Kageyana/robotrace_v1/README.md

# robotrace_v1

# 不具合情報
- リセット時にSDA端子がLOWに固定される.
  
  原因
  
  BNO055が通信中にリセットされBUSY状態になったから

参考

[STM32F1のI2Cの初期化でハマった](http://hima-tubusi.blogspot.com/2016/09/stm32f1i2c.html)

[STM32のI2C初期化で久しぶりにはまった](http://denshikousakusenka.blog.fc2.com/blog-entry-231.html)

[STM32のI2Cペリフェラルの初期化におけるヒント](https://www.stmcu.jp/design/document/technical_note/51180/)
