Kageyana/robotrace_v1/Circuit/robotrace_v1_main/robotrace_v1_main.step

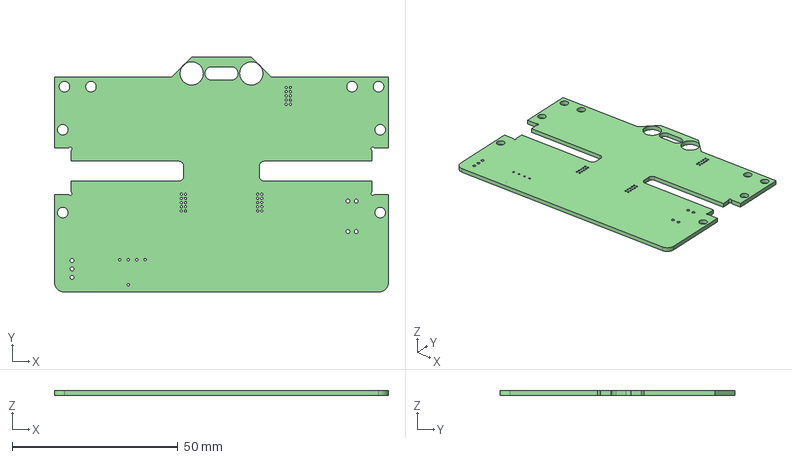
[picture p1: CAD file, 2023-08-02]
Circuit/robotrace_v1_main/robotrace_v1_main.step
100.8 x 71.0 x 1.60 mm
