Kageyana/robotrace_v1/Circuit/robotrace_v1_Linesensor/frontsensor2.dxf

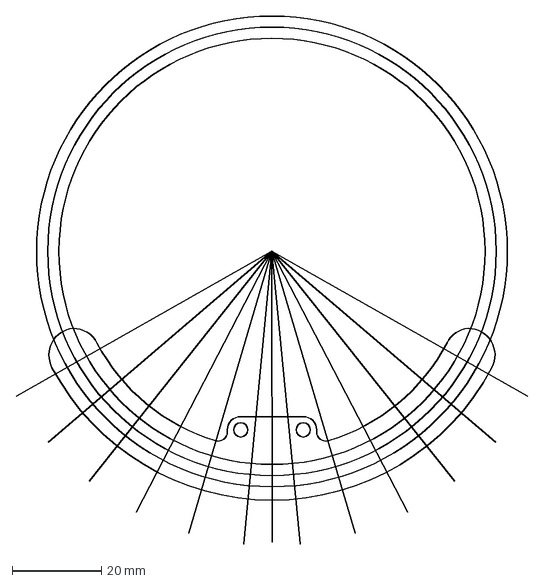
[picture p2: CAD file, 2023-08-02]
Circuit/robotrace_v1_Linesensor/frontsensor2.dxf
114.7 x 118.3 mm
