Kageyana/robotrace_v1/Circuit/robotrace_v1_main/plate.dxf

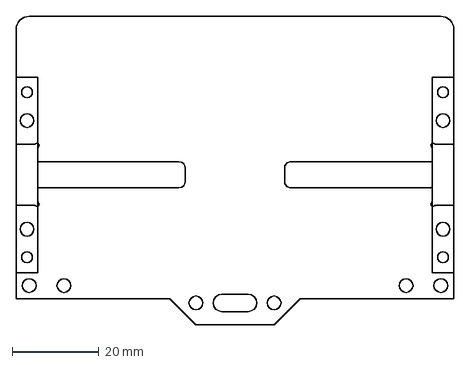
[picture p3: CAD file, 2023-08-02]
Circuit/robotrace_v1_main/plate.dxf
100.8 x 71.0 mm
