Kageyana/robotrace_v1/Circuit/robotrace_v1_Markersensor/Markersensor.dxf

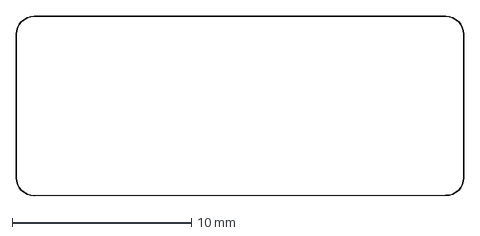
[picture p4: CAD file, 2023-08-02]
Circuit/robotrace_v1_Markersensor/Markersensor.dxf
25.0 x 10.0 mm
