Kageyana/robotrace_v1/Circuit/robotrace_v1_Linesensor/frontsensor.dxf

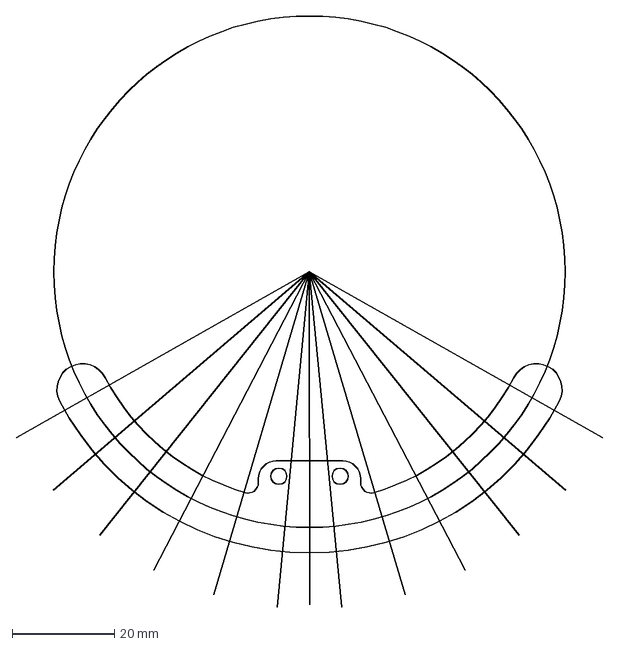
[picture p5: CAD file, 2023-08-02]
Circuit/robotrace_v1_Linesensor/frontsensor.dxf
114.7 x 115.6 mm
