Kageyana/robotrace_v1/Circuit/robotrace_v1_Linesensor/robotrace_v1_Linesensor.pdf

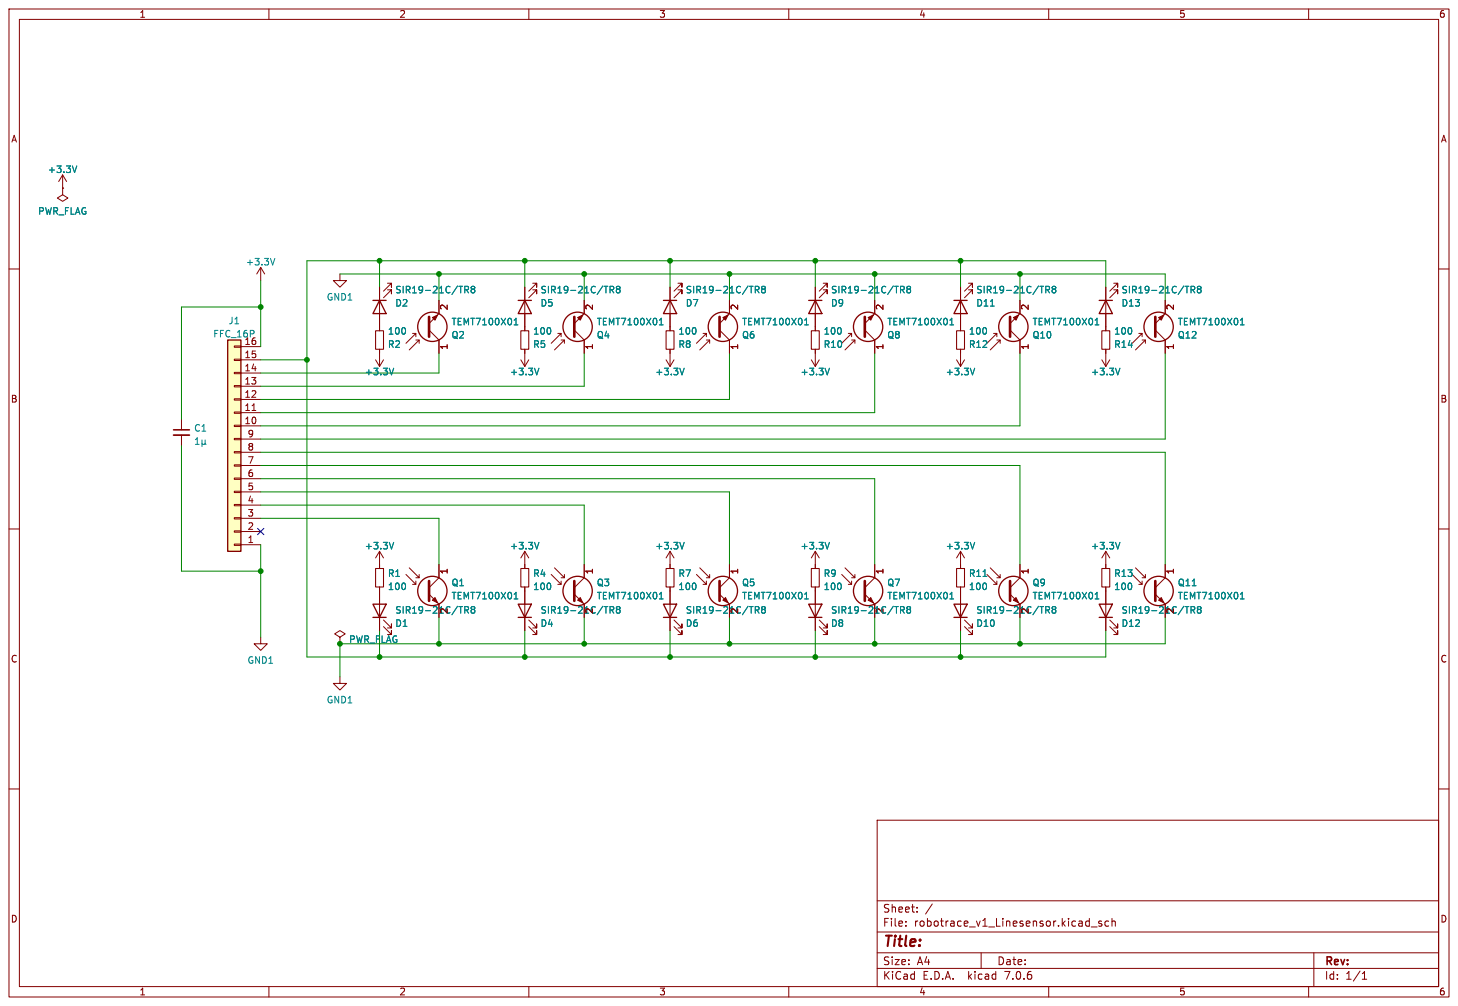
[picture p6: page 1]

Id: 1/1 Title: File: robotrace_v1_Linesensor.kicad_sch Sheet: /
