Kageyana/robotrace_v1/Circuit/robotrace_v1_Markersensor/robotrace_v1_Markersensor.pdf

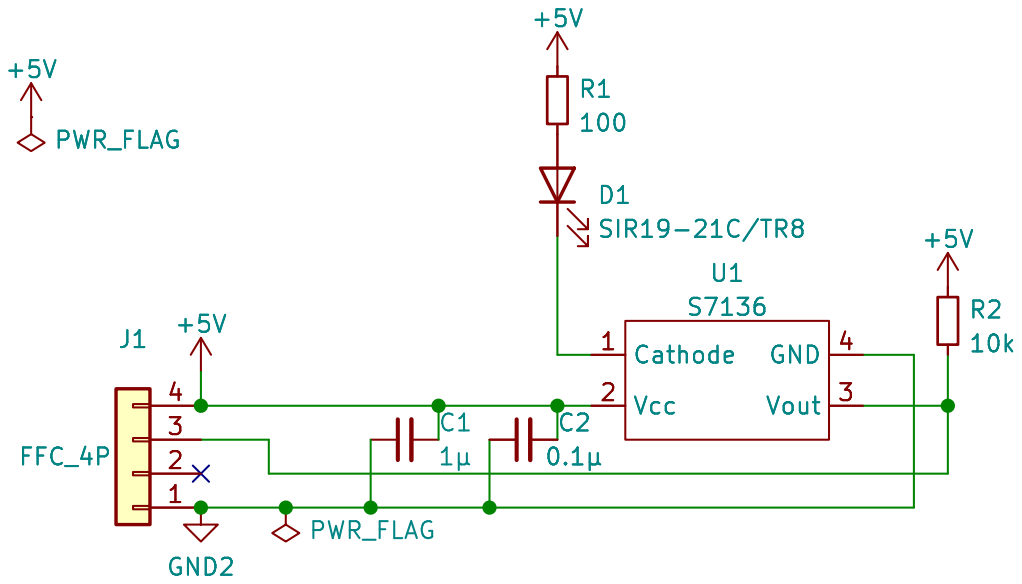
[picture p7: page 1]

Id: 1/1 Title: File: robotrace_v1_Markersensor.kicad_sch Sheet: /
