Kageyana/robotrace_v1/Circuit/robotrace_v1_main/main.pdf

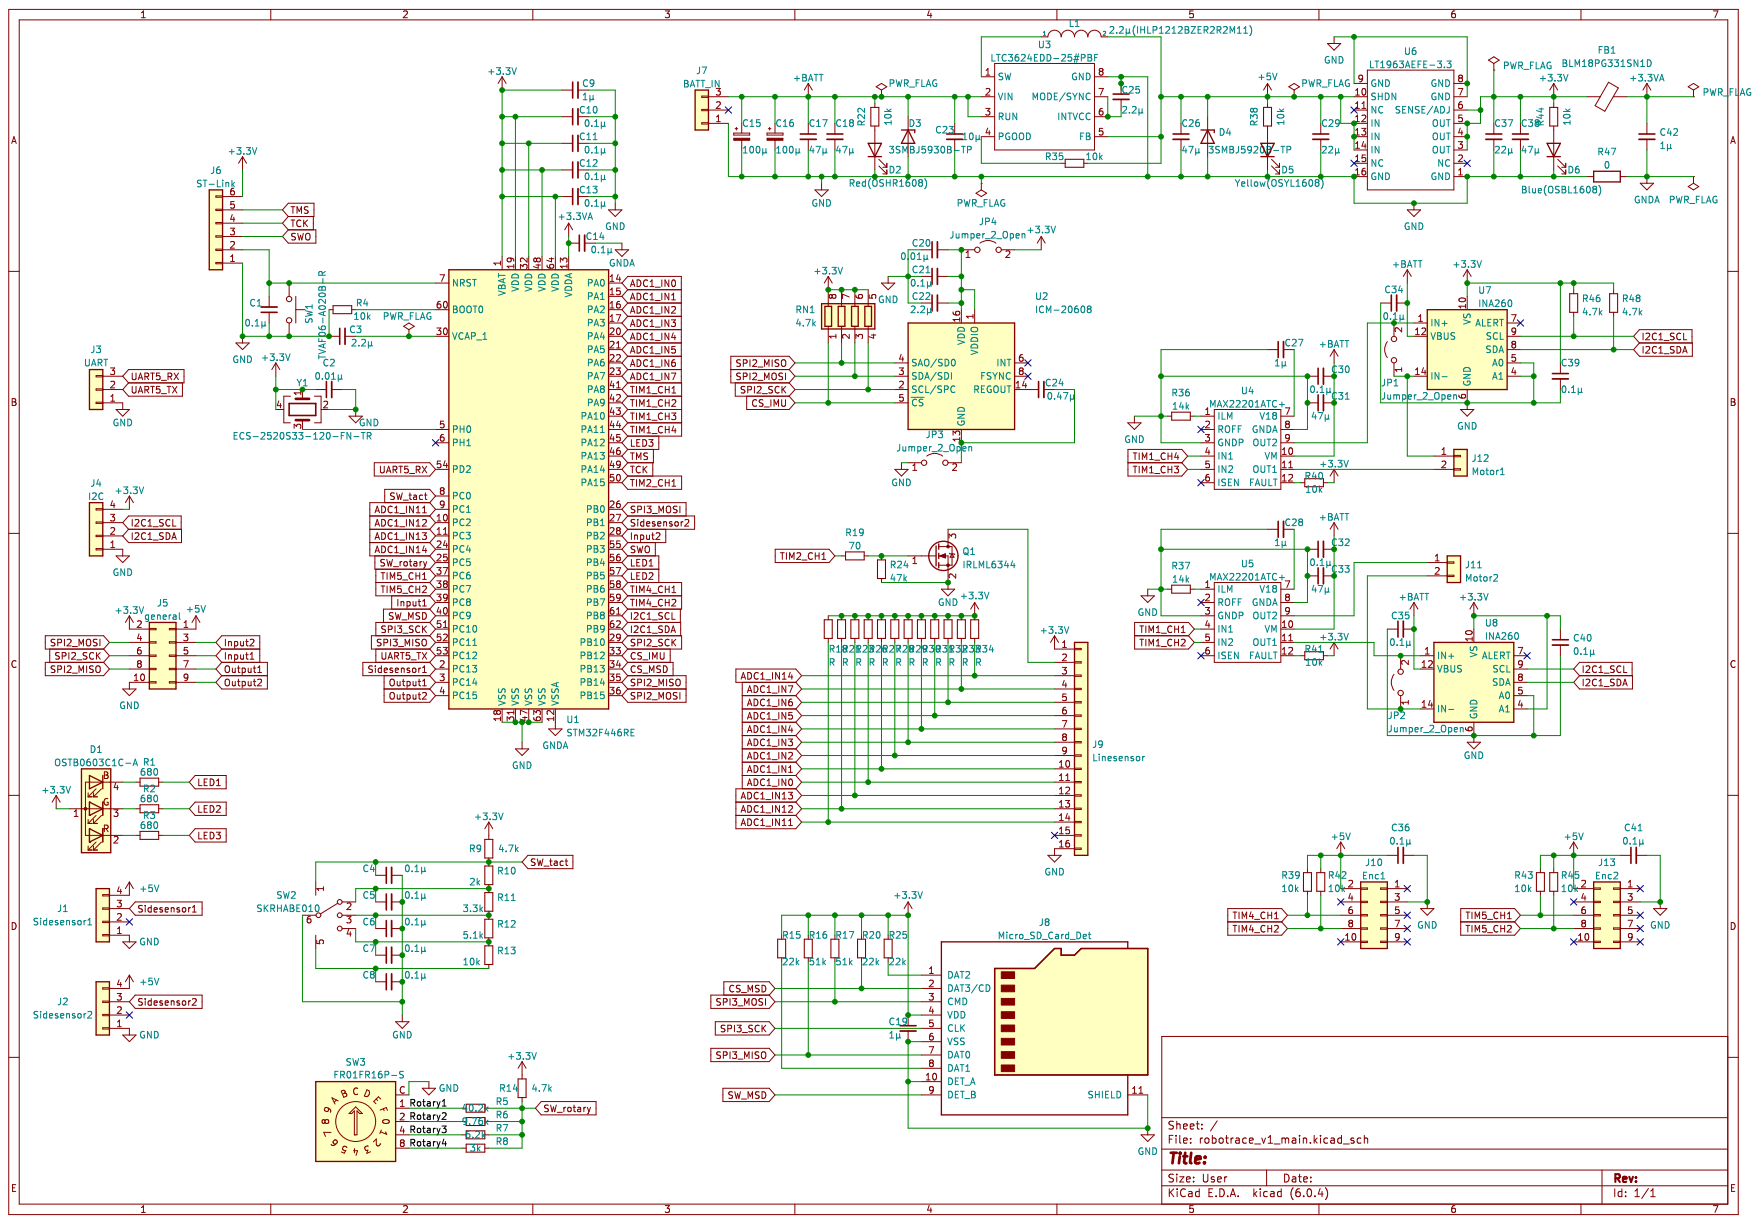
[picture p8: page 1]
