Kageyana/robotrace_v1/Circuit/robotrace_v1_main/robotrace_v1_main.kicad_pcb

## KiCad design Circuit/robotrace_v1_main/robotrace_v1_main.kicad_pcb (2023-08-02)

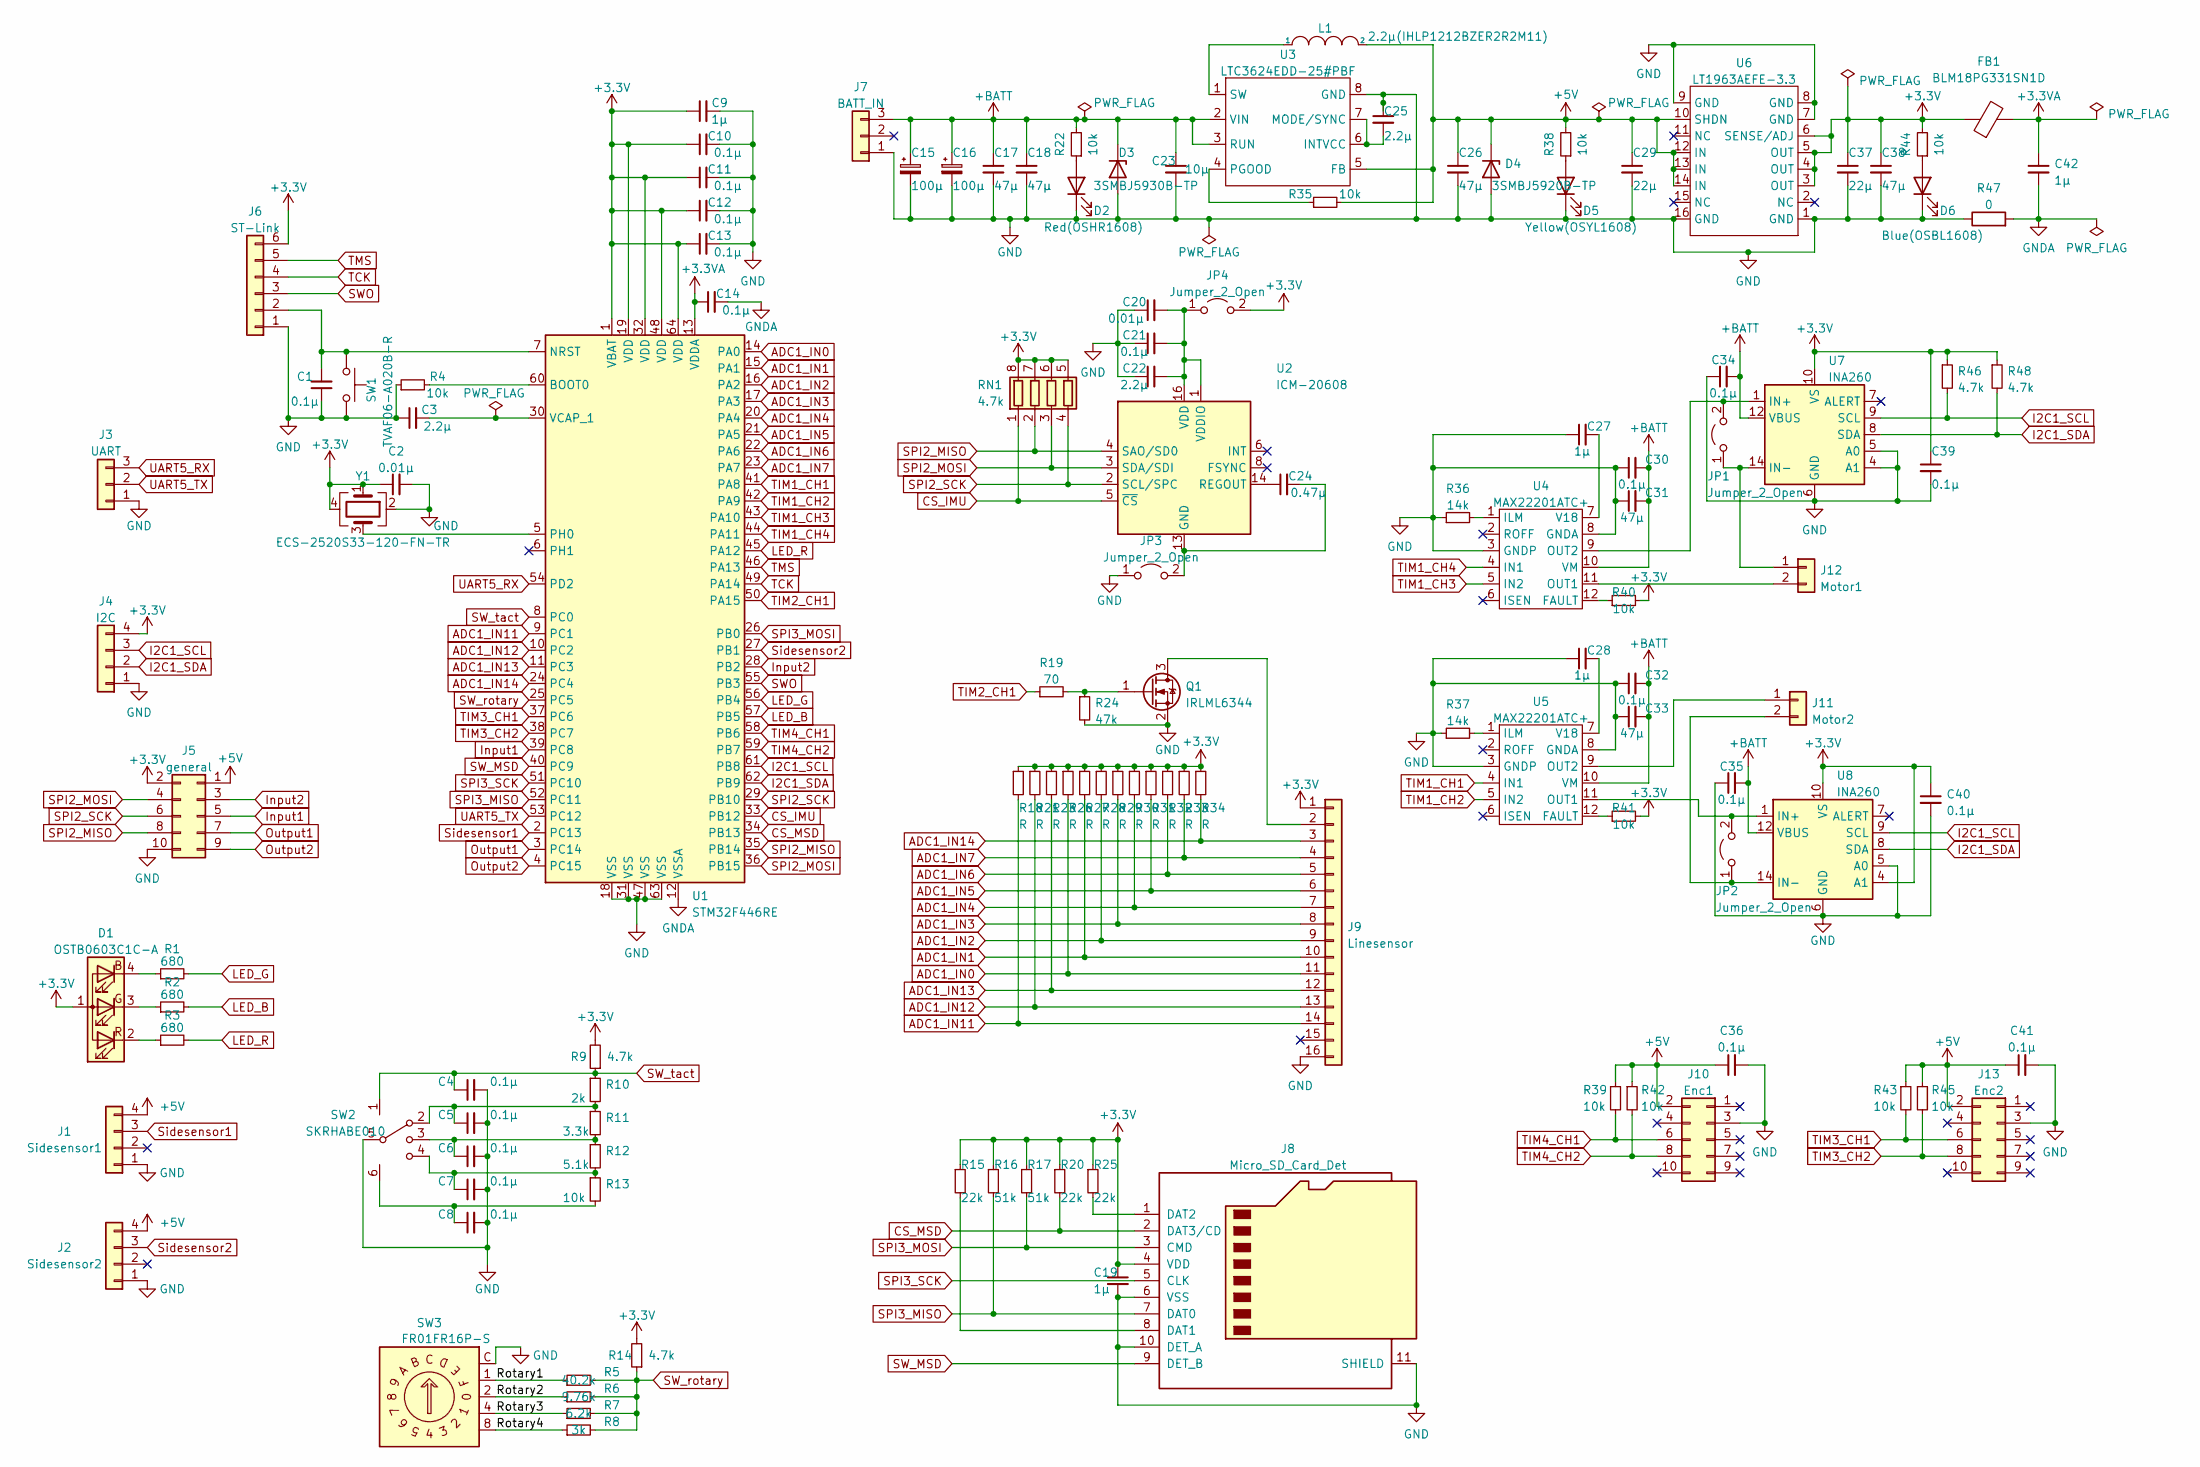
[picture p9: schematic robotrace_v1_main.kicad_sch]

Parts:
C1, C4, C5, C6, C7, C8, C10, C11, C12, C13, C14, C21, C30, C32, C34, C35, C36, C39, C40, C41: 0.1μ; C_0402_1005Metric_Pad0.74x0.62mm_HandSolder
C2, C20: 0.01μ; C_0402_1005Metric_Pad0.74x0.62mm_HandSolder
C3, C22, C25: 2.2μ; C_0402_1005Metric_Pad0.74x0.62mm_HandSolder
C9, C19, C27, C28, C42: 1μ; C_0402_1005Metric_Pad0.74x0.62mm_HandSolder
C15, C16: 100μ; CP_Elec_6.3x7.7
C17, C18, C26, C31, C33, C38: 47μ; C_1210_3225Metric_Pad1.33x2.70mm_HandSolder
C23: 10μ; C_0402_1005Metric_Pad0.74x0.62mm_HandSolder
C24: 0.47μ; C_0402_1005Metric_Pad0.74x0.62mm_HandSolder
C29: 22μ; C_0805_2012Metric_Pad1.18x1.45mm_HandSolder
C37: 22μ; C_0402_1005Metric_Pad0.74x0.62mm_HandSolder
D1: OSTB0603C1C-A; LED_Cree-PLCC4_2x2mm_CW
D2: Red(OSHR1608); LED_0603_1608Metric_Pad1.05x0.95mm_HandSolder
D3: 3SMBJ5930B-TP; D_SMA
D4: 3SMBJ5920B-TP; D_SMA
D5: Yellow(OSYL1608); LED_0603_1608Metric_Pad1.05x0.95mm_HandSolder
D6: Blue(OSBL1608); LED_0603_1608Metric_Pad1.05x0.95mm_HandSolder
FB1: BLM18PG331SN1D; D_0603_1608Metric
J1: Sidesensor1; Molex_FFC_1x4-1MP_P0.5mm_Horizontal
J2: Sidesensor2; Molex_FFC_1x4-1MP_P0.5mm_Horizontal
J3: UART; JST_SH_BM03B-SRSS-TB_1x03-1MP_P1.00mm_Vertical
J4: I2C; JST_SH_BM04B-SRSS-TB_1x04-1MP_P1.00mm_Vertical
J5: general; PinSocket_2x05_P1.27mm_Vertical
J6: ST-Link; JST_SH_BM06B-SRSS-TB_1x06-1MP_P1.00mm_Vertical
J7: BATT_IN; Molex_mini-SPOX_1x03_P2.54mm_Vertical
J8: Micro_SD_Card_Det; microSD_HC_Hirose_DM3AT-SF-PEJM5
J9: Linesensor; Molex_1x16_P0.50mm_Horizontal
J10: Enc1; PinSocket_2x05_P1.27mm_Vertical
J11: Motor2; Molex_mini-SPOX_1x02_P2.54mm_Vertical
J12: Motor1; Molex_mini-SPOX_1x02_P2.54mm_Vertical
J13: Enc2; PinSocket_2x05_P1.27mm_Vertical
JP1, JP2, JP3, JP4: Jumper_2_Open; SolderJumper-2_P1.3mm_Open_TrianglePad1.0x1.5mm
L1: 2.2μ(IHLP1212BZER2R2M11); L_Vishay_IHLP-1212
Q1: IRLML6344; SOT-23
R1, R2, R3: 680; R_0603_1608Metric
R4, R13, R22, R35, R38, R39, R40, R41, R42, R43, R44, R45: 10k; R_0603_1608Metric
R5: 40.2k; R_0603_1608Metric
R6: 9.76k; R_0603_1608Metric
R7: 6.2k; R_0603_1608Metric
R8: 3k; R_0603_1608Metric
R9, R14, R46, R48: 4.7k; R_0603_1608Metric
R10: 2k; R_0603_1608Metric
R11: 3.3k; R_0603_1608Metric
R12: 5.1k; R_0603_1608Metric
R15, R20, R25: 22k; R_0603_1608Metric
R16, R17: 51k; R_0603_1608Metric
R18, R21, R23, R26, R27, R28, R29, R30, R31, R32, R33, R34: R; R_0603_1608Metric
R19: 70; R_0603_1608Metric
R24: 47k; R_0603_1608Metric
R36, R37: 14k; R_0603_1608Metric
R47: 0; R_0603_1608Metric
RN1: 4.7k; R_Array_Convex_4x0402
SW1: TVAF06-A020B-R; SW_Push_SPST_NO_Alps_SKRK
SW2: SKRHABE010; SKRHAAE010
SW3: FR01FR16P-S
U1: STM32F446RE; LQFP-64_10x10mm_P0.5mm
U2: ICM-20608; LGA-16_3x3mm_P0.5mm_LayoutBorder3x5y
U3: LTC3624EDD-25#PBF; DFN-8-1EP_3x3mm_P0.5mm_EP1.65x2.38mm
U4, U5: MAX22201ATC+; DFN-12-1EP_3x3mm_P0.5mm_EP1.6x2.5mm
U6: LT1963AEFE-3.3; HTSSOP-16-1EP_4.4x5mm_P0.65mm_EP3.4x5mm
U7, U8: INA260; TSSOP-16_4.4x5mm_P0.65mm
Y1: ECS-2520S33-120-FN-TR; Crystal_SMD_EuroQuartz_MT-4Pin_3.2x2.5mm

Connections:
+3.3VA: C14.1, C42.1, FB1.2, U1.13 (VDDA)
+3V3: C2.1, C9.1, C10.1, C11.1, C12.1, C13.1, C19.1, C37.1, C38.1, C39.1, C40.1, D1.1 (A), FB1.1, J4.4, J5.2, J6.6, J8.4 (VDD), J9.1, JP4.2 (B), R9.2, R14.2, R15.1, R16.1, R17.1, R18.1, R20.1, R21.1, R23.1, R25.1, R26.1, R27.1, R28.1, R29.1, R30.1, R31.1, R32.1, R33.1, R34.1, R40.2, R41.2, R44.2, R46.1, R48.1, RN1.5 (R4.2), RN1.6 (R3.2), RN1.7 (R2.2), RN1.8 (R1.2), U1.1 (VBAT), U1.19 (VDD), U1.32 (VDD), U1.48 (VDD), U1.64 (VDD), U6.3 (OUT), U6.4 (OUT), U6.5 (OUT), U6.6 (SENSE/ADJ), U7.10 (VS), U8.4 (A1), U8.10 (VS), Y1.1, Y1.4
+5V: C26.1, C29.1, C36.1, C41.1, D4.1 (K), J1.4, J2.4, J5.1, J10.2, J13.2, L1.2, R35.2, R38.2, R39.1, R42.1, R43.1, R45.1, U3.5 (FB), U6.10 (SHDN), U6.12 (IN), U6.13 (IN), U6.14 (IN)
+BATT: C15.1, C16.1, C17.1, C18.1, C23.1, C30.2, C31.2, C32.2, C33.2, C34.2, C35.2, D3.1 (K), J7.3, R22.2, U3.2 (VIN), U3.3 (RUN), U4.10 (VM), U5.10 (VM), U7.12 (VBUS), U8.12 (VBUS)
/Rotary1: R5.1, SW3.1
/Rotary2: R6.1, SW3.2
/Rotary3: R7.1, SW3.4
/Rotary4: R8.1, SW3.8
ADC1_IN0: J9.11, R26.2, U1.14 (PA0)
ADC1_IN1: J9.10, R27.2, U1.15 (PA1)
ADC1_IN2: J9.9, R28.2, U1.16 (PA2)
ADC1_IN3: J9.8, R29.2, U1.17 (PA3)
ADC1_IN4: J9.7, R30.2, U1.20 (PA4)
ADC1_IN5: J9.6, R31.2, U1.21 (PA5)
ADC1_IN6: J9.5, R32.2, U1.22 (PA6)
ADC1_IN7: J9.4, R33.2, U1.23 (PA7)
ADC1_IN11: J9.14, R18.2, U1.9 (PC1)
ADC1_IN12: J9.13, R21.2, U1.10 (PC2)
ADC1_IN13: J9.12, R23.2, U1.11 (PC3)
ADC1_IN14: J9.3, R34.2, U1.24 (PC4)
CS_IMU: RN1.1 (R1.1), U1.33 (PB12), U2.5 (~CS)
CS_MSD: J8.2 (DAT3/CD), R20.2, U1.34 (PB13)
GNDA: C14.2, C42.2, R47.2, U1.12 (VSSA)
I2C1_SCL: J4.3, R46.2, U1.61 (PB8), U7.9 (SCL), U8.9 (SCL)
I2C1_SDA: J4.2, R48.2, U1.62 (PB9), U7.8 (SDA), U8.8 (SDA)
Input1: J5.5, U1.39 (PC8)
Input2: J5.3, U1.28 (PB2)
LED1: R1.2, U1.56 (PB4)
LED2: R2.2, U1.57 (PB5)
LED3: R3.2, U1.45 (PA12)
unnamed: C1.2, J6.2, SW1.1, U1.7 (NRST)
unnamed: C3.2, U1.30 (VCAP_1)
unnamed: C5.1, R10.2, R11.1, SW2.2
unnamed: C6.1, R11.2, R12.1, SW2.3
unnamed: C7.1, R12.2, R13.1, SW2.4
unnamed: C20.2, C21.2, C22.2, JP4.1 (A), U2.1 (VDDIO), U2.16 (VDD)
unnamed: C24.1, U2.14 (REGOUT)
unnamed: C24.2, JP3.2 (B), U2.9 (GND), U2.10 (GND), U2.11 (GND), U2.12 (GND), U2.13 (GND), U2.15 (GND)
unnamed: C25.2, U3.6 (INTVCC), U3.7 (MODE/SYNC)
unnamed: C27.2, U4.7 (V18)
unnamed: C28.2, U5.7 (V18)
unnamed: D1.2 (RK), R3.1
unnamed: D1.3 (GK), R2.1
unnamed: D1.4 (BK), R1.1
unnamed: D2.2 (A), R22.1
unnamed: D5.2 (A), R38.1
unnamed: D6.2 (A), R44.1
unnamed: J8.1 (DAT2), R25.2
unnamed: J8.8 (DAT1), R15.2
unnamed: J9.2, Q1.3 (D)
unnamed: J11.1, U5.9 (OUT2)
unnamed: J11.2, JP2.1 (A), U8.14 (IN-), U8.15 (IN-), U8.16 (IN-)
unnamed: J12.1, JP1.1 (A), U7.14 (IN-), U7.15 (IN-), U7.16 (IN-)
unnamed: J12.2, U4.11 (OUT1)
unnamed: JP1.2 (B), U4.9 (OUT2), U7.1 (IN+), U7.2 (IN+), U7.3 (IN+)
unnamed: JP2.2 (B), U5.11 (OUT1), U8.1 (IN+), U8.2 (IN+), U8.3 (IN+)
unnamed: L1.1, U3.1 (SW)
unnamed: Q1.1 (G), R19.2, R24.1
unnamed: R4.2, U1.60 (BOOT0)
unnamed: R35.1, U3.4 (PGOOD)
unnamed: R36.2, U4.1 (ILM)
unnamed: R37.2, U5.1 (ILM)
unnamed: R40.1, U4.12 (FAULT)
unnamed: R41.1, U5.12 (FAULT)
unnamed: U1.5 (PH0), Y1.3
Output1: J5.7, U1.3 (PC14)
Output2: J5.9, U1.4 (PC15)
SPI2_MISO: J5.8, RN1.2 (R2.1), U1.35 (PB14), U2.4 (SAO/SD0)
SPI2_MOSI: J5.4, RN1.3 (R3.1), U1.36 (PB15), U2.3 (SDA/SDI)
SPI2_SCK: J5.6, RN1.4 (R4.1), U1.29 (PB10), U2.2 (SCL/SPC)
SPI3_MISO: J8.7 (DAT0), R16.2, U1.52 (PC11)
SPI3_MOSI: J8.3 (CMD), R17.2, U1.26 (PB0)
SPI3_SCK: J8.5 (CLK), U1.51 (PC10)
SWO: J6.3, U1.55 (PB3)
SW_MSD: J8.9 (DET_B), U1.40 (PC9)
SW_rotary: R5.2, R6.2, R7.2, R8.2, R14.1, U1.25 (PC5)
SW_tact: C4.1, R9.1, R10.1, SW2.1, U1.8 (PC0)
Sidesensor1: J1.3, U1.2 (PC13)
Sidesensor2: J2.3, U1.27 (PB1)
TCK: J6.4, U1.49 (PA14)
TIM1_CH1: U1.41 (PA8), U5.4 (IN1)
TIM1_CH2: U1.42 (PA9), U5.5 (IN2)
TIM1_CH3: U1.43 (PA10), U4.5 (IN2)
TIM1_CH4: U1.44 (PA11), U4.4 (IN1)
TIM2_CH1: R19.1, U1.50 (PA15)
TIM4_CH1: J10.6, R39.2, U1.58 (PB6)
TIM4_CH2: J10.8, R42.2, U1.59 (PB7)
TIM5_CH1: J13.6, R43.2, U1.37 (PC6)
TIM5_CH2: J13.8, R45.2, U1.38 (PC7)
TMS: J6.5, U1.46 (PA13)
UART5_RX: J3.3, U1.54 (PD2)
UART5_TX: J3.2, U1.53 (PC12)

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
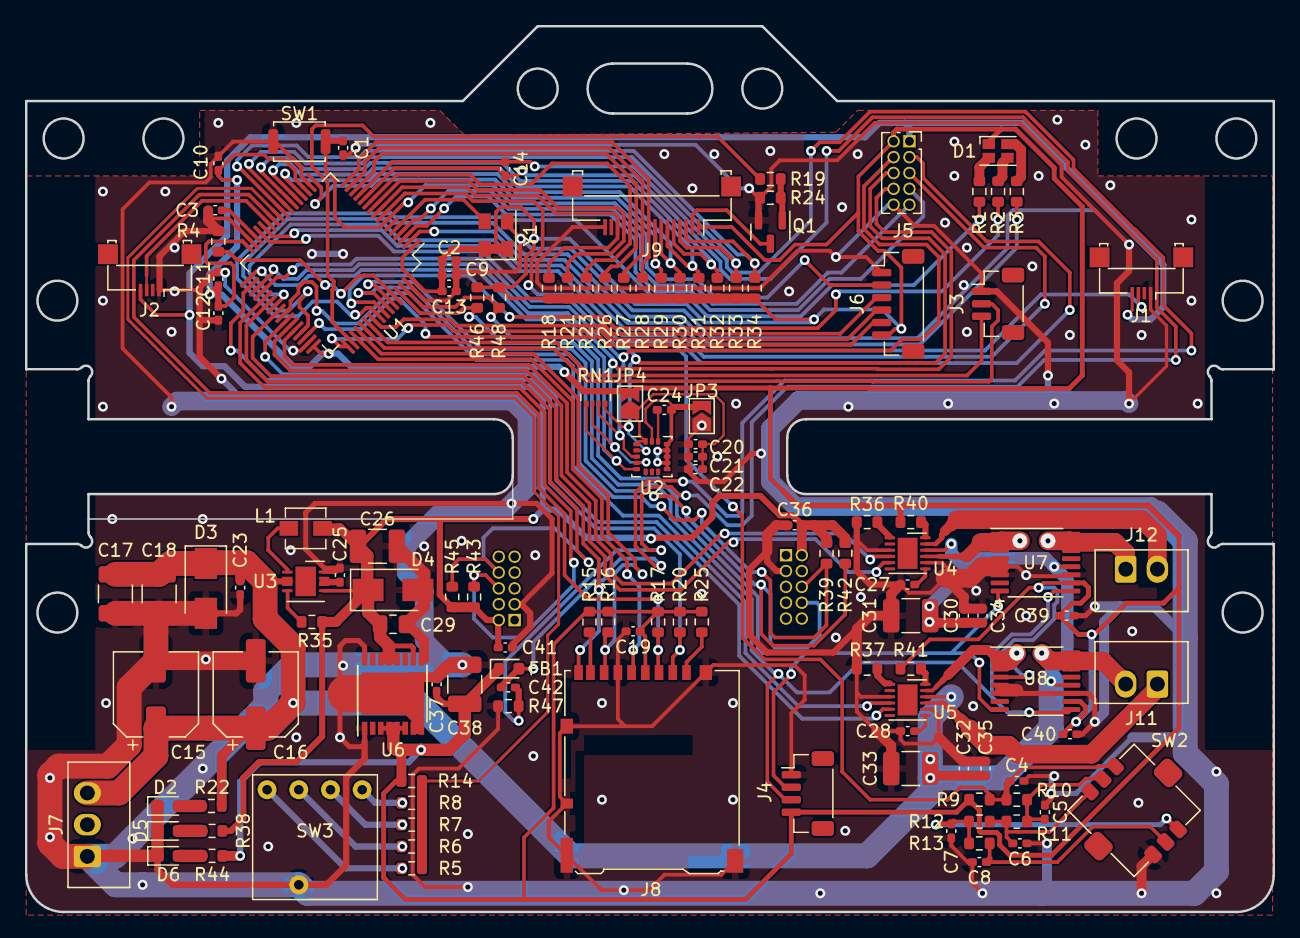
[picture p10: board robotrace_v1_main.kicad_pcb from above]

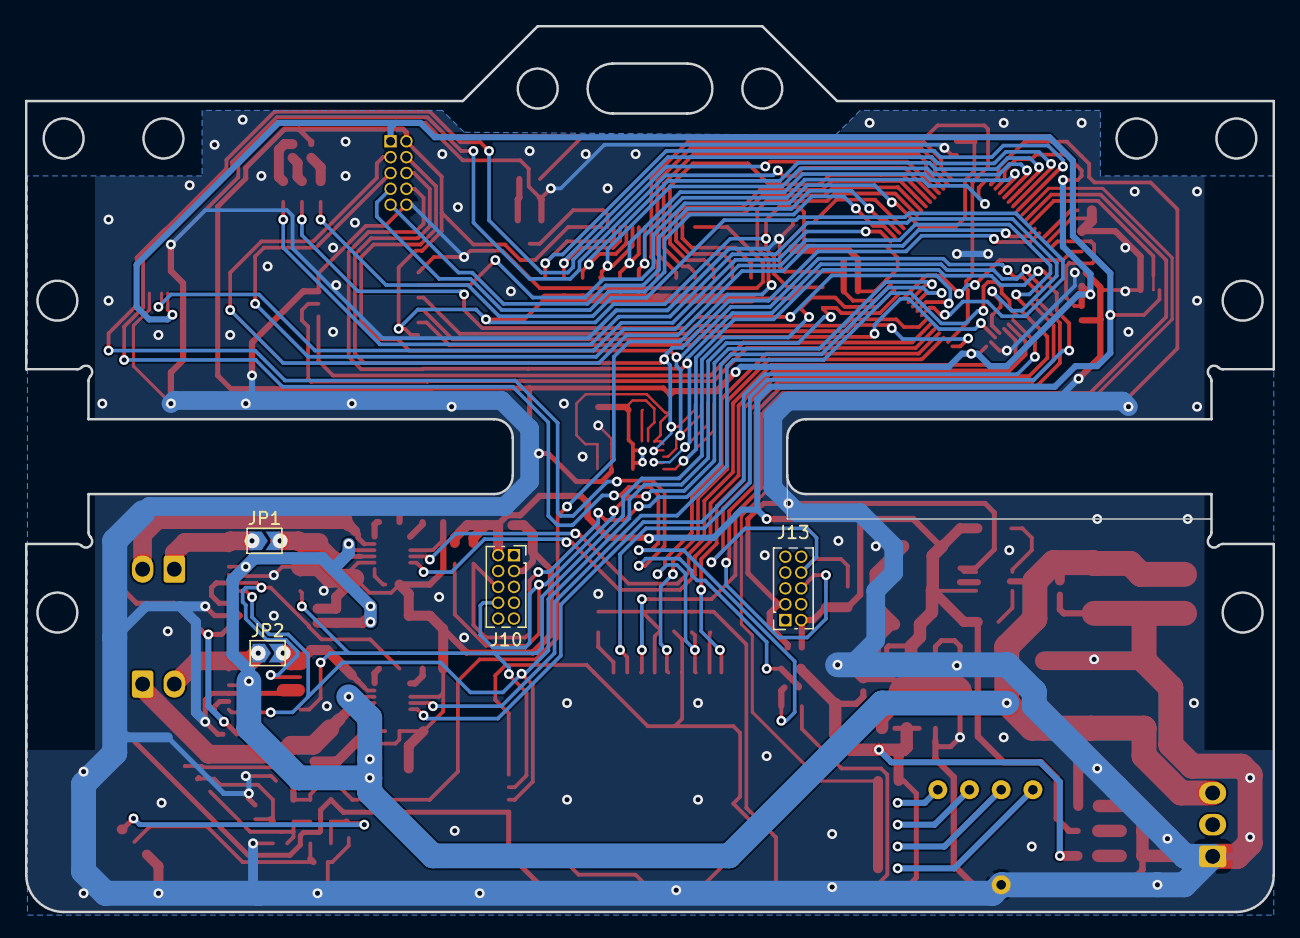
[picture p11: board robotrace_v1_main.kicad_pcb from below]

Board: 2 copper layers, 100.0 x 71.0 mm, 129 parts (4 on the bottom side), 94 nets.
