Kageyana/robotrace_v1/Circuit/robotrace_v1_Markersensor/robotrace_v1_Markersensor.kicad_pcb

## KiCad design Circuit/robotrace_v1_Markersensor/robotrace_v1_Markersensor.kicad_pcb (2023-08-02)

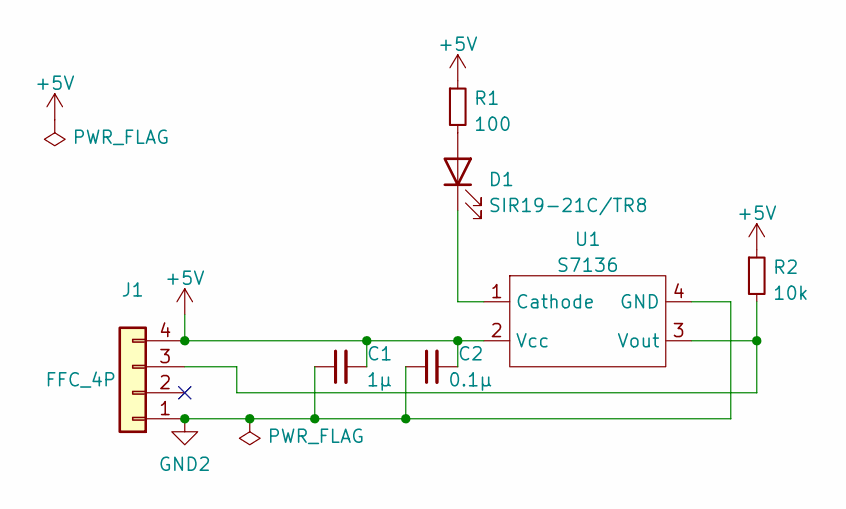
[picture p14: schematic robotrace_v1_Markersensor.kicad_sch]

Parts:
C1: 1μ; C_0402_1005Metric_Pad0.74x0.62mm_HandSolder
C2: 0.1μ; C_0402_1005Metric_Pad0.74x0.62mm_HandSolder
D1: SIR19-21C/TR8; LED_0603_1608Metric_Pad1.05x0.95mm_HandSolder
J1: FFC_4P; Molex_FFC_1x4-1MP_P0.5mm_Horizontal
R1: 100; R_0603_1608Metric_Pad0.98x0.95mm_HandSolder
R2: 10k; R_0603_1608Metric_Pad0.98x0.95mm_HandSolder
U1: S7136

Connections:
+5V: C1.2, C2.2, J1.4, R1.1, R2.1, U1.2 (Vcc)
GND2: C1.1, C2.1, J1.1, U1.4 (GND)
unnamed: D1.1 (K), U1.1 (Cathode)
unnamed: D1.2 (A), R1.2
unnamed: J1.3, R2.2, U1.3 (Vout)

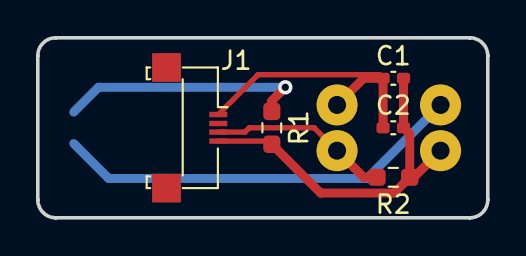
[picture p15: board robotrace_v1_Markersensor.kicad_pcb from above]

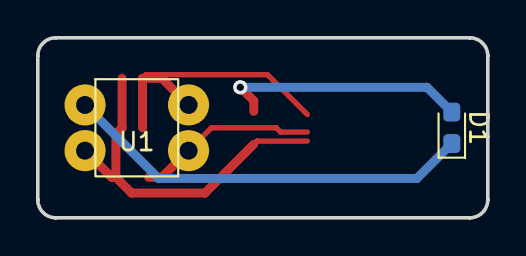
[picture p16: board robotrace_v1_Markersensor.kicad_pcb from below]

Board: 2 copper layers, 25.0 x 10.0 mm, 7 parts (2 on the bottom side), 5 nets.
