Kageyana/robotrace_v1/Circuit/robotrace_v1_Linesensor/total.kicad_pcb

## KiCad design Circuit/robotrace_v1_Linesensor/total.kicad_pcb (2023-08-02)

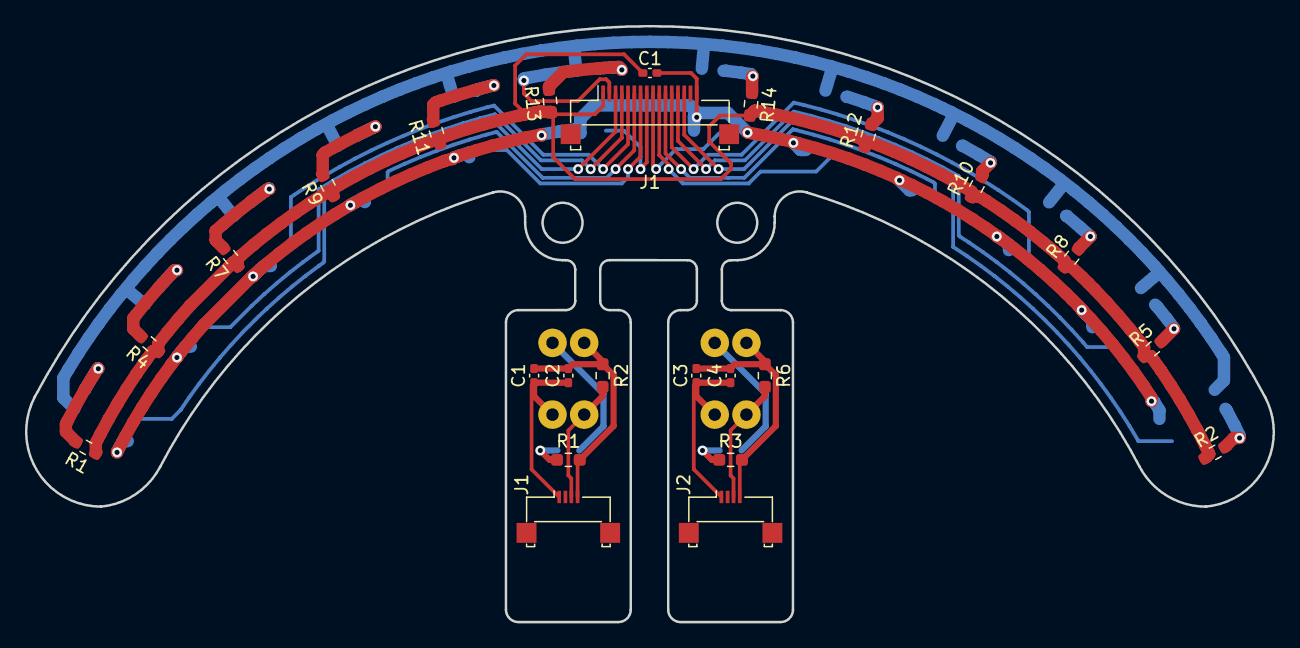
[picture p17: board total.kicad_pcb from above]

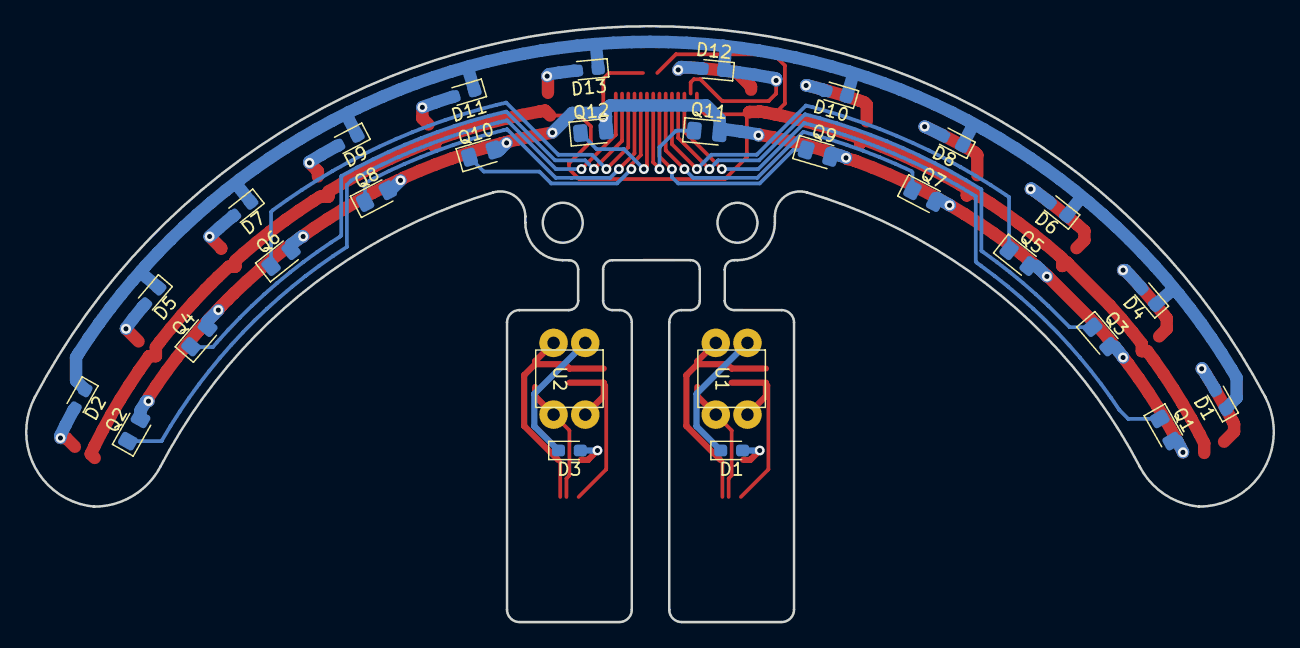
[picture p18: board total.kicad_pcb from below]

Board: 2 copper layers, 100.0 x 47.7 mm, 52 parts (28 on the bottom side), 29 nets.

Parts:
C1, C1#2, C3: 1μ; C_0402_1005Metric_Pad0.74x0.62mm_HandSolder
C2, C4: 0.1μ; C_0402_1005Metric_Pad0.74x0.62mm_HandSolder
D1, D1#2, D2, D3, D4, D5, D6, D7, D8, D9, D10, D11, D12, D13: SIR19-21C/TR8; LED_0603_1608Metric_Pad1.05x0.95mm_HandSolder
J1, J2: FFC_4P; Molex_FFC_1x4-1MP_P0.5mm_Horizontal
J1#2: FFC_16P; Molex_1x16_P0.50mm_Horizontal
Q1, Q2, Q3, Q4, Q5, Q6, Q7, Q8, Q9, Q10, Q11, Q12: TEMT7100X01; LED_0805_2012Metric_Pad1.15x1.40mm_HandSolder
R1, R1#2, R2#2, R3, R4, R5, R7, R8, R9, R10, R11, R12, R13, R14: 100; R_0603_1608Metric_Pad0.98x0.95mm_HandSolder
R2, R6: 10k; R_0603_1608Metric_Pad0.98x0.95mm_HandSolder
U1, U2: S7136

Connections:
+3V3: C1#2.1, J1#2.1, R1#2.1, R2#2.1, R4.1, R5.1, R7.1, R8.1, R9.1, R10.1, R11.1, R12.1, R13.1, R14.1
+5V: C1.2, C2.2, C3.2, C4.2, J1.4, J2.4, R1.1, R2.1, R3.1, R6.1, U1.2 (Vcc), U2.2 (Vcc)
GND1: C1#2.2, J1#2.16, Q1.2 (E), Q2.2 (E), Q3.2 (E), Q4.2 (E), Q5.2 (E), Q6.2 (E), Q7.2 (E), Q8.2 (E), Q9.2 (E), Q10.2 (E), Q11.2 (E), Q12.2 (E)
GND2: C1.1, C2.1, C3.1, C4.1, J1.1, J2.1, U1.4 (GND), U2.4 (GND)
unnamed: D1.1 (K), D1#2.1 (K), D2.1 (K), D3.1 (K), D4.1 (K), D5.1 (K), D6.1 (K), D7.1 (K), D8.1 (K), D9.1 (K), D10.1 (K), D11.1 (K), D12.1 (K), D13.1 (K), J1#2.2, U1.1 (Cathode), U2.1 (Cathode)
unnamed: D1.2 (A), D1#2.2 (A), D3.2 (A), R1.2, R1#2.2, R3.2
unnamed: D2.2 (A), R2#2.2
unnamed: D4.2 (A), R4.2
unnamed: D5.2 (A), R5.2
unnamed: D6.2 (A), R7.2
unnamed: D7.2 (A), R8.2
unnamed: D8.2 (A), R9.2
unnamed: D9.2 (A), R10.2
unnamed: D10.2 (A), R11.2
unnamed: D11.2 (A), R12.2
unnamed: D12.2 (A), R13.2
unnamed: D13.2 (A), R14.2
unnamed: J1.3, J1#2.3, J2.3, Q1.1 (C), R2.2, R6.2, U1.3 (Vout), U2.3 (Vout)
unnamed: J1#2.4, Q3.1 (C)
unnamed: J1#2.5, Q5.1 (C)
unnamed: J1#2.6, Q7.1 (C)
unnamed: J1#2.7, Q9.1 (C)
unnamed: J1#2.8, Q11.1 (C)
unnamed: J1#2.9, Q12.1 (C)
unnamed: J1#2.10, Q10.1 (C)
unnamed: J1#2.11, Q8.1 (C)
unnamed: J1#2.12, Q6.1 (C)
unnamed: J1#2.13, Q4.1 (C)
unnamed: J1#2.14, Q2.1 (C)
