Kageyana/robotrace_v1/robotrace_v1/Core/Src/main.c

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
/* Includes ------------------------------------------------------------------*/
#include "main.h"
#include "fatfs.h"

ADC_HandleTypeDef hadc1;
ADC_HandleTypeDef hadc2;
DMA_HandleTypeDef hdma_adc1;

I2C_HandleTypeDef hi2c1;

SPI_HandleTypeDef hspi2;
SPI_HandleTypeDef hspi3;

TIM_HandleTypeDef htim1;
TIM_HandleTypeDef htim2;
TIM_HandleTypeDef htim3;
TIM_HandleTypeDef htim4;
TIM_HandleTypeDef htim6;
TIM_HandleTypeDef htim7;

UART_HandleTypeDef huart5;

void SystemClock_Config(void);
static void MX_GPIO_Init(void);
static void MX_DMA_Init(void);
static void MX_ADC1_Init(void);
static void MX_I2C1_Init(void);
static void MX_SPI2_Init(void);
static void MX_TIM1_Init(void);
static void MX_TIM2_Init(void);
static void MX_UART5_Init(void);
static void MX_TIM3_Init(void);
static void MX_TIM4_Init(void);
static void MX_SPI3_Init(void);
static void MX_TIM6_Init(void);
static void MX_ADC2_Init(void);
static void MX_TIM7_Init(void);
/**
  * @brief  The application entry point.
  * @retval int
  */
int main(void)
{
  /* MCU Configuration--------------------------------------------------------*/

  /* Reset of all peripherals, Initializes the Flash interface and the Systick. */
  HAL_Init();

  /* Configure the system clock */
  SystemClock_Config();

  /* Initialize all configured peripherals */
  MX_GPIO_Init();
  MX_DMA_Init();
  MX_ADC1_Init();
  MX_I2C1_Init();
  MX_SPI2_Init();
  MX_TIM1_Init();
  MX_TIM2_Init();
  MX_UART5_Init();
  MX_TIM3_Init();
  MX_TIM4_Init();
  MX_SPI3_Init();
  MX_TIM6_Init();
  MX_ADC2_Init();
  MX_FATFS_Init();
  MX_TIM7_Init();
  /* USER CODE BEGIN 2 */
  initSystem();

  /* USER CODE END 2 */

  /* Infinite loop */
  /* USER CODE BEGIN WHILE */
  while (1)
  {
    loopSystem();
    /* USER CODE END WHILE */

    /* USER CODE BEGIN 3 */
  }
  /* USER CODE END 3 */
}

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
/* USER CODE BEGIN 4 */
void HAL_TIM_PeriodElapsedCallback(TIM_HandleTypeDef *htim)
{
    if(htim->Instance == TIM6){
      Interrupt1ms();
    }
    if(htim->Instance == TIM7){
      Interrupt100us();
      // cntRun++;
    }
}
// ADC interpput
void HAL_ADC_ConvCpltCallback(ADC_HandleTypeDef* AdcHandle) {
  getLineSensor();
}

// printf
int _write(int file, char *ptr, int len)
{
  int DataIdx;
  for(DataIdx=0; DataIdx<len; DataIdx++)
  {
    ITM_SendChar(*ptr++);
  }
  return len;
}
/* USER CODE END 4 */
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
