Kageyana/robotrace_v1/robotrace_v1/robotrace_v1.ioc

Mcu.UserName=STM32F446RETx
PA0-WKUP.Signal=ADCx_IN0
PA1.Signal=ADCx_IN1
PA10.Signal=S_TIM1_CH3
PA11.Signal=S_TIM1_CH4
PA12.GPIO_Label=LED_R
PA12.Signal=GPIO_Output
PA13.GPIO_Label=TMS
PA13.Signal=SYS_JTMS-SWDIO
PA14.GPIO_Label=TCK
PA14.Signal=SYS_JTCK-SWCLK
PA15.Signal=S_TIM2_CH1_ETR
PA2.Signal=ADCx_IN2
PA3.Signal=ADCx_IN3
PA4.Signal=ADCx_IN4
PA5.Signal=ADCx_IN5
PA6.Signal=ADCx_IN6
PA7.Signal=ADCx_IN7
PA8.Signal=S_TIM1_CH1
PA9.Signal=S_TIM1_CH2
PB0.Signal=SPI3_MOSI
PB1.GPIO_Label=Sidesensor2
PB1.Signal=GPIO_Input
PB10.Signal=SPI2_SCK
PB12.GPIO_Label=CS_IMU
PB12.Signal=GPIO_Output
PB13.GPIO_Label=CS_MSD
PB13.Signal=GPIO_Output
PB14.Signal=SPI2_MISO
PB15.Signal=SPI2_MOSI
PB2.GPIO_Label=Input2
PB2.Signal=GPIO_Input
PB3.GPIO_Label=SWO
PB3.Signal=SYS_JTDO-SWO
PB4.GPIO_Label=LED_G
PB4.Signal=GPIO_Output
PB5.GPIO_Label=LED_B
PB5.Signal=GPIO_Output
PB6.Signal=S_TIM4_CH1
PB7.Signal=S_TIM4_CH2
PB8.Signal=I2C1_SCL
PB9.Signal=I2C1_SDA
PC0.Signal=ADCx_IN10
PC1.Signal=ADCx_IN11
PC10.Signal=SPI3_SCK
PC11.Signal=SPI3_MISO
PC12.Signal=UART5_TX
PC13.GPIO_Label=Sidesensor1
PC13.Signal=GPIO_Input
PC14-OSC32_IN.GPIO_Label=Output1
PC14-OSC32_IN.Signal=GPIO_Output
PC15-OSC32_OUT.GPIO_Label=Output2
PC15-OSC32_OUT.Signal=GPIO_Output
PC2.Signal=ADCx_IN12
PC3.Signal=ADCx_IN13
PC4.Signal=ADCx_IN14
PC5.Signal=ADCx_IN15
PC6.Signal=S_TIM3_CH1
PC7.Signal=S_TIM3_CH2
PC8.GPIO_Label=Input1
PC8.Signal=GPIO_Input
PC9.GPIO_Label=SW_MSD
PC9.Signal=GPIO_Input
PD2.Signal=UART5_RX
PH0-OSC_IN.Signal=RCC_OSC_IN
PH1-OSC_OUT.Signal=RCC_OSC_OUT
