Kageyana/robotrace_v1/robotrace_v1/Core/Inc/main.h

#define Sidesensor1_Pin GPIO_PIN_13
#define Sidesensor1_GPIO_Port GPIOC
#define Output1_Pin GPIO_PIN_14
#define Output1_GPIO_Port GPIOC
#define Output2_Pin GPIO_PIN_15
#define Output2_GPIO_Port GPIOC
#define Sidesensor2_Pin GPIO_PIN_1
#define Sidesensor2_GPIO_Port GPIOB
#define Input2_Pin GPIO_PIN_2
#define Input2_GPIO_Port GPIOB
#define CS_IMU_Pin GPIO_PIN_12
#define CS_IMU_GPIO_Port GPIOB
#define CS_MSD_Pin GPIO_PIN_13
#define CS_MSD_GPIO_Port GPIOB
#define Input1_Pin GPIO_PIN_8
#define Input1_GPIO_Port GPIOC
#define SW_MSD_Pin GPIO_PIN_9
#define SW_MSD_GPIO_Port GPIOC
#define LED_R_Pin GPIO_PIN_12
#define LED_R_GPIO_Port GPIOA
#define TMS_Pin GPIO_PIN_13
#define TMS_GPIO_Port GPIOA
#define TCK_Pin GPIO_PIN_14
#define TCK_GPIO_Port GPIOA
#define SWO_Pin GPIO_PIN_3
#define SWO_GPIO_Port GPIOB
#define LED_G_Pin GPIO_PIN_4
#define LED_G_GPIO_Port GPIOB
#define LED_B_Pin GPIO_PIN_5
#define LED_B_GPIO_Port GPIOB
