Kageyana/robotrace_v1/robotrace_v1/Core/Inc/control.h

#ifndef CONTROL_H_
#define CONTROL_H_
//====================================//
// インクルード
//====================================//
#include "main.h"
//====================================//
// シンボル定義
//====================================//
// 機体諸元

// 速度パラメータ関連
#define PARAM_STRAIGHT              1.5F
#define PARAM_CURVE                 1.2F
#define PARAM_STOP                  0.8F
#define PARAM_BOOST_STRAIGHT        2.2F
#define PARAM_BOOST_1500            2.2F
#define PARAM_BOOST_800             2.0F
#define PARAM_BOOST_700             1.8
#define PARAM_BOOST_600             1.7F
#define PARAM_BOOST_500             1.6F
#define PARAM_BOOST_400             1.5F
#define PARAM_BOOST_300             1.4F
#define PARAM_BOOST_200             1.3F
#define PARAM_BOOST_100             1.1F

// ゴール
#define COUNT_GOAL              2       // ゴールマーカーを読む回数

typedef struct {
    float straight;
    float curve;
    float stop;
    float boostStraight;
    float boost1500;
    float boost800;
    float boost700;
    float boost600;
    float boost500;
    float boost400;
    float boost300;
    float boost200;
    float boost100;
} speedParam;
//====================================//
// グローバル変数の宣言
//====================================//
// パターン、モード関連
extern uint8_t  patternTrace;	// パターン番号
extern bool     modeLCD;		// LCD表示選択
extern bool     modeLOG;        // ログ取得状況
extern bool     initMSD;        // microSD初期化状況
extern bool     initLCD;        // LCD初期化状況
extern bool     initIMU;        // IMU初期化状況
extern bool     useIMU;         // IMU使用状況
extern bool     initCurrent;    // 電流センサ初期化状況
extern uint8_t  modeCurve;	    // カーブ判断 0:直線 1:カーブ進入
extern int16_t  countdown;

// パラメータ関連
// extern uint8_t  paramSpeed[20];
extern speedParam targetParam;

extern uint32_t analogVal[12];         // ADC結果格納配列

// マーカー関連
extern uint8_t  courseMarker;
extern uint8_t  beforeCourseMarker;
extern uint32_t cntMarker;

//====================================//
// プロトタイプ宣言
//====================================//
void initSystem (void);
void loopSystem (void);
void emargencyStop (void);
void countDown (void);
void checkCurve(void);

#endif // CONTROL_H_
