Kageyana/robotrace_v1/robotrace_v1/Core/Inc/markerSensor.h

#ifndef MARKERSENSOR_H_
#define MARKERSENSOR_H_

//====================================//
// インクルード
//====================================//
#include "main.h"
//====================================//
// シンボル定義
//====================================//
#define RIGHTMARKER      0x1
#define LEFTMARKER       0x2
#define CROSSLINE       0x3

//====================================//
// グローバル変数の宣言
//====================================//
extern uint8_t  SGmarker;
extern uint8_t  crossLine;
//====================================//
// プロトタイプ宣言
//====================================//
uint8_t getMarkerSensor ( void );
uint8_t checkMarker( void );
void checkGoalMarker(void);
bool checkCrossLine(void);
#endif // MARKERSENSOR_H_
