Kageyana/robotrace_v1/robotrace_v1/Core/Inc/lineSensor.h

#ifndef LINESENSOR_H_
#define LINESENSOR_H_

//====================================//
// インクルード
//====================================//
#include "main.h"
//====================================//
// シンボル定義
//====================================//
#define NUM_SENSORS      12
#define THITA_SENSOR     11.0F       // ラインセンサの間隔(角度)
#define BASEVAL          4095.0F
#define ls_COUNTERPERIOD htim2.Init.Period
//====================================//
// グローバル変数の宣言
//====================================//
extern uint16_t		lSensor[NUM_SENSORS];
extern float        angleSensor;
extern bool			lineSensorState;

extern uint16_t		lSensorCari[NUM_SENSORS];
extern uint16_t		lSensorOffset[NUM_SENSORS];
extern uint8_t      modeCalLinesensors;

//====================================//
// プロトタイプ宣言
//====================================//
void powerLinesensors(uint8_t onoff);
void getLineSensor(void);
void getAngleSensor(void);
void calibrationLinesensor (void);

#endif // LINESENSOR_H_
