Kageyana/robotrace_v1/robotrace_v1/Core/Src/encoder.c

//====================================//
// インクルード
//====================================//
#include "encoder.h"
//====================================//
// グローバル変数の宣言
//====================================//
uint16_t    encBufR = 0;
uint16_t    encBufL = 0;
int16_t     encCurrentR = 0;
int16_t     encCurrentL = 0;
int16_t     encCurrentN = 0;
int32_t     encTotalR = 0;
int32_t     encTotalL = 0;
int32_t     encTotalN = 0;

// 外部変数
int32_t     enc1 = 0;
int32_t     encRightMarker = 0;
int32_t     encCurve = 0;
/////////////////////////////////////////////////////////////////////
// モジュール名 getEncoder
// 処理概要     1ms間のエンコーダカウントを算出する
// 引数         なし
// 戻り値       なし
/////////////////////////////////////////////////////////////////////
void getEncoder(void) {
    uint16_t encRawR, encRawL;

    // エンコーダカウントを取得
    encRawR = TIM4 -> CNT;
	encRawL = TIM3 -> CNT;

    // 1msあたりのカウント
    encCurrentR = encBufR - encRawR;
    encCurrentL = encBufL - encRawL;
    encCurrentN = (encCurrentR + encCurrentL ) / 2;

    // カウントの積算(回転方向が逆なのでマイナスで積算)
    encTotalR += encCurrentR;
    encTotalL += encCurrentL;
    encTotalN += encCurrentN;

    // 外部変数
    enc1 += encCurrentN;
    encRightMarker += encCurrentN;
    encCurve += encCurrentN;
    // 前回値を更新
    encBufR = encRawR;
    encBufL = encRawL;
}
///////////////////////////////////////////////////////////////////////////
// モジュール名 encMM
// 処理概要     mmをエンコーダのパルス数に変換して返す
// 引数         mm:変換する長さ[mm]
// 戻り値       変換したパルス数
///////////////////////////////////////////////////////////////////////////
int32_t encMM( int16_t mm ) {
	return PALSE_MILLIMETER * abs(mm);
}
