Kageyana/robotrace_v1/robotrace_v1/Core/Src/setup.c

//====================================//
// インクルード
//====================================//
#include "setup.h"
//====================================//
// グローバル変数の宣言
//====================================//
uint8_t 	start = 0;		// 0:セットアップ中	1:セットアップ完了

// タイマ関連
uint16_t	cntSetup1 = 0;			// セットアップで使用
uint16_t	cntSetup2 = 0;			// セットアップで使用
uint16_t	cntSwitchUD = 0;		// スイッチ判定用右
uint16_t 	cntSwitchLR = 0;		// スイッチ判定用左
uint16_t	cntSwitchUDLong = 0;	// スイッチ長押し判定用右
uint16_t	cntSwitchLRLong = 0;	// スイッチ長押し判定用左

// スイッチ関連
int8_t pushLR = 0;
int8_t pushUD = 0;

// パターン関連
uint8_t push = 0;
uint8_t push1 = 0;
int16_t patternSensors = 1;
int16_t patternSensorLine = 1;
int16_t patternSensorAccele = 1;
int16_t patternSensorGyro = 1;
int16_t patternParameter1 = 1;
int16_t patternParameter2 = 1;
int16_t patternParameter3 = 1;
int16_t patternParameter4 = 1;
int16_t patternGain = 1;
int16_t patternSpeedseting = 1;
int16_t patternLog = 1;
int16_t patternCalibration = 1;

// フラグ関連
uint8_t motor_test = 0;
uint8_t trace_test = 0;
int16_t	calTimes = 1;
int16_t	calTimesNow = 0;
uint8_t bright = 0;

// パラメータ関連
int16_t motorTestPwm = 200;
///////////////////////////////////////////////////////////////
// モジュール名 setup
// 処理概要     走行前設定
// 引数         なし
// 戻り値       なし
///////////////////////////////////////////////////////////////
void setup( void )
{
	uint8_t cntLed;

	// ディップスイッチで項目選択
	switch ( swValRotary ) {
		//------------------------------------------------------------------
		// スタート待ち
		//------------------------------------------------------------------
		case HEX_START:
			

			switch (patternCalibration) {
				case 1:
					setTargetSpeed(0);
					motorPwmOutSynth( 0, veloCtrl.pwm, 0, 0);

					lcdRowPrintf(UPPER, "start   ");
					if (lSensorOffset[0] > 0) {
						lcdRowPrintf(LOWER, "Finish  ");
					} else {
						lcdRowPrintf(LOWER, "Unfinish");
					}
					
					if (swValTact == SW_PUSH) {
						cntSetup1 = 0;
						powerLinesensors(1);	// 先に点灯させて安定させる
						patternCalibration = 2;
					}
					break;

				case 2:
					// 開始準備
					lcdRowPrintf(LOWER, "%4d",cntSetup1);
					if (cntSetup1 > 1000) {
						BNO055val.angle.z = 0.0;	// 角度リセット
						yawRateCtrl.Int = 0.0;		// I成分リセット
						useIMU = true;
						setTargetSpeed(0);			// 目標速度0[m/s]
						enc1 = 0;
						modeCalLinesensors = 1; 	// キャリブレーション開始
						patternCalibration = 3;
					}
					break;

				case 3:
					// 左旋回
					setTargetAngularVelocity(CALIBRATIONSPEED);
					motorPwmOutSynth(0, veloCtrl.pwm, yawRateCtrl.pwm, 0);
					if (BNO055val.angle.z > 0.85) {
						patternCalibration = 4;
					}
					break;

				case 4:
					// 停止
					setTargetSpeed(0);
					motorPwmOutSynth(0, veloCtrl.pwm, 0, 0);
					if (abs(encCurrentN) == 0) {
						patternCalibration = 5;
					}
					break;

				case 5:
					// 右旋回
					setTargetAngularVelocity(-CALIBRATIONSPEED);
					motorPwmOutSynth(0, veloCtrl.pwm, yawRateCtrl.pwm, 0);
					if (BNO055val.angle.z < -0.85) {
						patternCalibration = 6;
					}
					break;

				case 6:
					// 停止
					setTargetSpeed(0);
					motorPwmOutSynth(0, veloCtrl.pwm, 0, 0);
					if (abs(encCurrentN) == 0) {
						patternCalibration = 7;
					}
					break;

				case 7:
					// 初期位置に戻る
					setTargetAngularVelocity(CALIBRATIONSPEED);
					motorPwmOutSynth(0, veloCtrl.pwm, yawRateCtrl.pwm, 0);
					if (BNO055val.angle.z > 0) {
						modeCalLinesensors = 0;
						patternCalibration = 8;
					}
					break;

				case 8:
					// 停止
					motorPwmOutSynth( 0, veloCtrl.pwm, 0, 0);
					if (abs(encCurrentN) == 0) {
						useIMU = false;
						patternCalibration = 1;
						start = 1;
					}
					break;
			
				default:
					break;
				}
			break;
		//------------------------------------------------------------------
		// パラメータ調整(通常トレース)
		//------------------------------------------------------------------
		case HEX_SPEED_PARAM:
			dataTuningLR( &patternParameter1, 1, 1, 13);
			
			switch( patternParameter1 ) {
				case 1:
					// 通常走行速度
					dataTuningUDF( &targetParam.straight, 0.1, 0.0, 10.0 );
					lcdRowPrintf(UPPER, "STRAIGHT");
					lcdRowPrintf(LOWER, "  %3gm/s", targetParam.straight);
					break;
				case 2:
					// 停止速度
					dataTuningUDF( &targetParam.curve, 0.1, 0.0, 10.0 );
					lcdRowPrintf(UPPER, "CURVE   ");
					lcdRowPrintf(LOWER, "  %3gm/s", targetParam.curve);
					break;
				case 3:
					// 停止速度
					dataTuningUDF( &targetParam.stop, 0.1, 0.0, 10.0 );
					lcdRowPrintf(UPPER, "STOP    ");
					lcdRowPrintf(LOWER, "  %3gm/s", targetParam.stop);
					break;
				case 4:
					// 2次走行_直線
					dataTuningUDF( &targetParam.boostStraight, 0.1, 0.0, 10.0 );
					lcdRowPrintf(UPPER, "BST STRT");
					lcdRowPrintf(LOWER, "  %3gm/s", targetParam.boostStraight);
					break;
				case 5:
					// 2次走行_R1500
					dataTuningUDF( &targetParam.boost1500, 0.1, 0.0, 10.0 );
					lcdRowPrintf(UPPER, "BST 1500");
					lcdRowPrintf(LOWER, "  %3gm/s", targetParam.boost1500);
					break;
				case 6:
					// 2次走行_R800
					dataTuningUDF( &targetParam.boost800, 0.1, 0.0, 10.0 );
					lcdRowPrintf(UPPER, "BST  800");
					lcdRowPrintf(LOWER, "  %3gm/s", targetParam.boost800);
					break;
				case 7:
					// 2次走行_R700
					dataTuningUDF( &targetParam.boost700, 0.1, 0.0, 10.0 );
					lcdRowPrintf(UPPER, "BST  700");
					lcdRowPrintf(LOWER, "  %3gm/s", targetParam.boost700);
					break;
				case 8:
					// 2次走行_R600
					dataTuningUDF( &targetParam.boost600, 0.1, 0.0, 10.0 );
					lcdRowPrintf(UPPER, "BST  600");
					lcdRowPrintf(LOWER, "  %3gm/s", targetParam.boost600);
					break;
				case 9:
					// 2次走行_R500
					dataTuningUDF( &targetParam.boost500, 0.1, 0.0, 10.0 );
					lcdRowPrintf(UPPER, "BST  500");
					lcdRowPrintf(LOWER, "  %3gm/s", targetParam.boost500);
					break;
				case 10:
					// 2次走行_R400
					dataTuningUDF( &targetParam.boost400, 0.1, 0.0, 10.0 );
					lcdRowPrintf(UPPER, "BST  400");
					lcdRowPrintf(LOWER, "  %3gm/s", targetParam.boost400);
					break;
				case 11:
					// 2次走行_R300
					dataTuningUDF( &targetParam.boost300, 0.1, 0.0, 10.0 );
					lcdRowPrintf(UPPER, "BST  300");
					lcdRowPrintf(LOWER, "  %3gm/s", targetParam.boost300);
					break;
				case 12:
					// 2次走行_R200
					dataTuningUDF( &targetParam.boost200, 0.1, 0.0, 10.0 );
					lcdRowPrintf(UPPER, "BST  200");
					lcdRowPrintf(LOWER, "  %3gm/s", targetParam.boost200);
					break;
				case 13:
					// 2次走行_R100
					dataTuningUDF( &targetParam.boost100, 0.1, 0.0, 10.0 );
					lcdRowPrintf(UPPER, "BST  100");
					lcdRowPrintf(LOWER, "  %3gm/s", targetParam.boost100);
					break;
			}
			break;
		//------------------------------------------------------------------
		// Sensors test
		//------------------------------------------------------------------
		case HEX_SENSORS:
			dataTuningLR( &patternSensors, 1, 1, 10 );

			if(patternSensors != 8) {
				useIMU = false;
			}

			switch( patternSensors ) {
				case 1:
					// LED
					lcdRowPrintf(UPPER, "LED     ");
					lcdRowPrintf(LOWER, "        ");
					cntLed = 0x00;
					if ( swValTact == SW_PUSH) {
						cntLed = 0x00;
						while( cntLed <= 0x7 ) {
							ledOut( cntLed );
							cntLed++;
							HAL_Delay(400);
						}
						ledOut( 0 );
					}
					break;
									
				case 2:
					// エンコーダ
					lcdRowPrintf(UPPER, "R %6d",encTotalR);
					lcdRowPrintf(LOWER, "L %6d",encTotalN);

					if(swValTact == SW_PUSH) {
						encTotalN = 0;
					}
					break;
							
				case 3:
					// モーターテスト
					lcdRowPrintf(UPPER, "Motor   ");
					lcdRowPrintf(LOWER, "   %4d%%",motorTestPwm);
					// モータ回転
					dataTuningUD ( &motorTestPwm, 100, 0, 1000 );
					if ( motor_test == 1 ) {
						motorPwmOut(motorTestPwm,motorTestPwm);
					} else {
						motorPwmOut(0, 0);
					}
										
					data_select( &motor_test, SW_PUSH );
					break;

				case 4:
					// マーカーセンサ
					lcdRowPrintf(UPPER, "Marker  ");
					lcdRowPrintf(LOWER, "     0x%x", getMarkerSensor());
					break;

				case 5:
					// 電流センサ
					lcdRowPrintf(UPPER, "   %3.0fmA", CurrntR);
					lcdRowPrintf(LOWER, "   %3.0fmA", CurrntL);

					motorTestPwm = 80;
					data_select( &motor_test, SW_PUSH );
					if ( motor_test == 1 ) {
						motorPwmOut(motorTestPwm,motorTestPwm);
					} else {
						motorPwmOut(0, 0);
					}
					break;

				case 6:
					// ラインセンサ
					dataTuningUD( &patternSensorLine, 1, 1, 6 );
					if (bright == 1) {
						powerLinesensors(1);
					} else {
						powerLinesensors(0);
					}

					data_select( &bright, SW_PUSH );

					switch( patternSensorLine ) {
						case 1:
							lcdRowPrintf(UPPER, "L1  %4d",lSensorCari[4]+lSensorCari[5]+lSensorCari[6]+lSensorCari[7]);
							lcdRowPrintf(LOWER, "L2  %4d",lSensorCari[1]);
							break;

						case 2:
							lcdRowPrintf(UPPER, "L3  %4d",lSensorCari[2]);
							lcdRowPrintf(LOWER, "L4  %4d",lSensorCari[3]);
							break;
						case 3:
							lcdRowPrintf(UPPER, "L5  %4d",lSensorCari[4]);
							lcdRowPrintf(LOWER, "L6  %4d",lSensorCari[5]);
							break;
						
						case 4:
							lcdRowPrintf(UPPER, "R1  %4d",lSensorCari[11]);
							lcdRowPrintf(LOWER, "R2  %4d",lSensorCari[10]);
							break;

						case 5:
							lcdRowPrintf(UPPER, "R3  %4d",lSensorCari[9]);
							lcdRowPrintf(LOWER, "R4  %4d",lSensorCari[8]);
							break;

						case 6:
							lcdRowPrintf(UPPER, "R5  %4d",lSensorCari[7]);
							lcdRowPrintf(LOWER, "R6  %4d",lSensorCari[6]);
							break;
					}
					break;

				case 7:
					// 加速度
					dataTuningUD( &patternSensorAccele, 1, 1, 3 );

					switch( patternSensorAccele ) {
						case 1:
							lcdRowPrintf(UPPER, "X accele");
							lcdRowPrintf(LOWER, "    %4.0f",BNO055val.accele.x);
							break;
						case 2:
							lcdRowPrintf(UPPER, "Y accele");
							lcdRowPrintf(LOWER, "    %4.0f",BNO055val.accele.y);
							break;
						case 3:
							lcdRowPrintf(UPPER, "Z accele");
							lcdRowPrintf(LOWER, "    %4.0f",BNO055val.accele.z);
							break;
					}
					break;

				case 8:
					// 角速度
					dataTuningUD( &patternSensorGyro, 1, 1, 6 );

					if (swValTact == SW_PUSH) {
						BNO055val.angle.z = 0.0;
					}
					useIMU = true;		// IMU 使用開始

					switch( patternSensorGyro ) {
						case 1:
							lcdRowPrintf(UPPER, "X gyro  ");
							lcdRowPrintf(LOWER, "   %3.2f",BNO055val.gyro.x);
							break;
						case 2:
							lcdRowPrintf(UPPER, "Y gyro  ");
							lcdRowPrintf(LOWER, "   %3.2f",BNO055val.gyro.y);
							break;
						case 3:
							lcdRowPrintf(UPPER, "Z gyro  ");
							lcdRowPrintf(LOWER, "   %3.2f",BNO055val.gyro.z);
							break;
						case 4:
							lcdRowPrintf(UPPER, "X angle ");
							lcdRowPrintf(LOWER, "   %3.2f",BNO055val.angle.x);
							break;
						case 5:
							lcdRowPrintf(UPPER, "Y angle ");
							lcdRowPrintf(LOWER, "   %3.2f",BNO055val.angle.y);
							break;
						case 6:
							lcdRowPrintf(UPPER, "Z angle ");
							lcdRowPrintf(LOWER, "   %3.2f",BNO055val.angle.z);
							break;
					}
					break;
				case 9:
					// PID制御量
					targetSpeed = 120;
					lcdRowPrintf(UPPER, "tra%5d",lineTraceCtrl.pwm);
					lcdRowPrintf(LOWER, "vel%5d",yawCtrl.pwm);
					break;
				case 10:
					// 仮想センサ角度
					if (bright == 1) {
						powerLinesensors(1);
					} else {
						powerLinesensors(0);
					}

					lcdRowPrintf(UPPER, "Anglesen");
					lcdRowPrintf(LOWER, "   %3.1f", angleSensor);
					break;
			} // switch patternSensors
			break;
		//------------------------------------------------------------------
		// Log
		//------------------------------------------------------------------
		case HEX_LOG:
			lcdRowPrintf(UPPER, "LOG     ");
			if (initMSD) {
				dataTuningLR( &fileIndexLog, 1, 0, endFileIndex );
				if (fileNumbers[fileIndexLog] == analizedNumber) {
					lcdRowPrintf(LOWER, "O   %4d", fileNumbers[fileIndexLog]);
				} else {
					lcdRowPrintf(LOWER, "    %4d", fileNumbers[fileIndexLog]);
				}

				// ログ解析
				if (swValTact == SW_UP) {
					// マーカー基準解析
					numPPADarry = readLogMarker(fileNumbers[fileIndexLog]);
					if (numPPADarry > 0) {
						lcdRowPrintf(UPPER, "Marker  ");
						lcdRowPrintf(LOWER, " success");
						optimalTrace = BOOST_MARKER;
					} else {
						lcdRowPrintf(LOWER, "   false");
					}
					HAL_Delay(1000);
				} else if (swValTact == SW_DOWN) {
					// 距離基準解析
					numPPADarry = readLogDistance(fileNumbers[fileIndexLog]);
					if (numPPADarry > 0) {
						lcdRowPrintf(UPPER, "Distance");
						lcdRowPrintf(LOWER, " success");
						optimalTrace = BOODT_DISTANCE;
						optimalIndex = 0;
					} else {
						lcdRowPrintf(LOWER, "   false");
					}
					HAL_Delay(1000);
				}
			} else {
				lcdRowPrintf(LOWER, "  no MSD");
			}
			break;
		//------------------------------------------------------------------
		// キャリブレーション(ラインセンサ) 
		//------------------------------------------------------------------
		case HEX_CALIBRATION:
			switch (patternCalibration) {
				case 1:
					// スイッチ入力待ち
					dataTuningUD( &calTimes, 1, 1, 9);

					setTargetSpeed(0);
					motorPwmOutSynth( 0, veloCtrl.pwm, 0, 0);
					lcdRowPrintf(UPPER, "Calibrat");
					lcdRowPrintf(LOWER, "%d  times", calTimes);
					if (swValTact == SW_PUSH) {
						cntSetup1 = 0;
						enc1 = 0;
						powerLinesensors(1);	// 先に点灯させて安定させる
						patternCalibration = 2;
					}
					break;

				case 2:
					// 開始準備
					lcdRowPrintf(LOWER, "%4d",cntSetup1);
					if (cntSetup1 > 1000) {
						BNO055val.angle.z = 0.0;	// 角度リセット
						yawRateCtrl.Int = 0.0;		// I成分リセット
						useIMU = true;
						setTargetSpeed(0);			// 目標速度0[m/s]
						enc1 = 0;
						modeCalLinesensors = 1; 	// キャリブレーション開始
						patternCalibration = 3;
					}
					break;

				case 3:
					// 左旋回
					setTargetAngularVelocity(CALIBRATIONSPEED);
					motorPwmOutSynth(0, veloCtrl.pwm, yawRateCtrl.pwm, 0);
					if (BNO055val.angle.z > 0.85) {
						patternCalibration = 4;
					}
					break;

				case 4:
					// 停止
					setTargetSpeed(0);
					motorPwmOutSynth(0, veloCtrl.pwm, 0, 0);
					if (abs(encCurrentN) == 0) {
						patternCalibration = 5;
					}
					break;

				case 5:
					// 右旋回
					setTargetAngularVelocity(-CALIBRATIONSPEED);
					motorPwmOutSynth(0, veloCtrl.pwm, yawRateCtrl.pwm, 0);
					if (BNO055val.angle.z < -0.85) {
						patternCalibration = 6;
					}
					break;

				case 6:
					// 停止
					setTargetSpeed(0);
					motorPwmOutSynth(0, veloCtrl.pwm, 0, 0);
					if (abs(encCurrentN) == 0) {
						patternCalibration = 7;
					}
					break;

				case 7:
					// 初期位置に戻る
					setTargetAngularVelocity(CALIBRATIONSPEED);
					motorPwmOutSynth(0, veloCtrl.pwm, yawRateCtrl.pwm, 0);
					if (BNO055val.angle.z > 0) {
						modeCalLinesensors = 0;
						patternCalibration = 8;
					}
					break;

				case 8:
					// 停止
					motorPwmOutSynth( 0, veloCtrl.pwm, 0, 0);
					if (abs(encCurrentN) == 0) {
						calTimesNow++;
						if (calTimesNow >= calTimes) {
							calTimesNow = 0;
							useIMU = false;
							patternCalibration = 1;
						} else {
							patternCalibration = 3;
						}
					}
					break;
			
				default:
					break;
				}
			break;
		//------------------------------------------------------------------
		// ゲイン調整(直線トレース)
		//------------------------------------------------------------------
		case HEX_PID_TRACE:
			lcdRowPrintf(UPPER, "Trace   ");
			
			data_select( &trace_test, SW_PUSH );
			// PUSHでトレースON/OFF
			if ( trace_test == 1 ) {
				motorPwmOutSynth( lineTraceCtrl.pwm, 0, 0, 0);
				powerLinesensors(1);
			} else {
				motorPwmOutSynth( 0, 0, 0, 0);
				powerLinesensors(0);
			}
			
			dataTuningLR( &patternGain, 1, 1, 3);

			if ( (cntSetup1 / 250) % 2 != 0 ) {
				lcdRowPrintf(LOWER, "%2d %2d %2d", lineTraceCtrl.kp, lineTraceCtrl.ki, lineTraceCtrl.kd);
			}
			switch( patternGain ) {
				case 1:
					// kp
					dataTuningUD ( &lineTraceCtrl.kp, 1, 0, 99 );
					//値を点滅
					if ( (cntSetup1 / 250) % 2 == 0 ) {
						lcdRowPrintf(LOWER, "   %2d %2d", lineTraceCtrl.ki, lineTraceCtrl.kd);
					}
					break;
				case 2:
					// ki
					dataTuningUD ( &lineTraceCtrl.ki, 1, 0, 99 );
					//値を点滅
					if ( (cntSetup1 / 250) % 2 == 0 ) {
						lcdRowPrintf(LOWER, "%2d    %2d", lineTraceCtrl.kp, lineTraceCtrl.kd);
					}
					break;
				case 3:
					// kd
					dataTuningUD ( &lineTraceCtrl.kd, 1, 0, 99 );
					//値を点滅
					if ( (cntSetup1 / 250) % 2 == 0 ) {
						lcdRowPrintf(LOWER, "%2d %2d   ", lineTraceCtrl.kp, lineTraceCtrl.ki);
					}
					break;
			}
			break;
		//------------------------------------------------------------------
		// ゲイン調整(速度)
		//------------------------------------------------------------------
		case HEX_PID_SPEED:
			lcdRowPrintf(UPPER, "Speed   ");
			dataTuningLR( &patternGain, 1, 1, 3);
			if ( (cntSetup1 / 250) % 2 != 0 ) {
				lcdRowPrintf(LOWER, "%2d %2d %2d", veloCtrl.kp, veloCtrl.ki, veloCtrl.kd);
			}
			switch( patternGain ) {
				case 1:
					// kp
					dataTuningUD ( &veloCtrl.kp, 1, 0, 99 );
					//値を点滅
					if ( (cntSetup1 / 250) % 2 == 0 ) {
						lcdRowPrintf(LOWER, "   %2d %2d", veloCtrl.ki, veloCtrl.kd);
					}
					break;
				case 2:
					// ki
					dataTuningUD ( &veloCtrl.ki, 1, 0, 99 );
					//値を点滅
					if ( (cntSetup1 / 250) % 2 == 0 ) {
						lcdRowPrintf(LOWER, "%2d    %2d", veloCtrl.kp, veloCtrl.kd);
					}
					break;
				case 3:
					// kd
					dataTuningUD ( &veloCtrl.kd, 1, 0, 99 );
					//値を点滅
					if ( (cntSetup1 / 250) % 2 == 0 ) {
						lcdRowPrintf(LOWER, "%2d %2d   ", veloCtrl.kp, veloCtrl.ki);
					}
					break;
			}
			break;
		//------------------------------------------------------------------
		// ゲイン調整(角速度)
		//------------------------------------------------------------------
		case HEX_PID_ANGULAR:
			lcdRowPrintf(UPPER, "Angular ");
			
			setTargetAngularVelocity(0);
			setTargetSpeed(0);

			data_select( &trace_test, SW_PUSH );
			// PUSHでトレースON/OFF
			if ( trace_test == 1 ) {
				useIMU = true;
				motorPwmOutSynth( 0, veloCtrl.pwm, yawRateCtrl.pwm, 0 );
			} else {
				useIMU = false;
				motorPwmOutSynth( 0, 0, 0, 0 );
			}
			
			dataTuningLR( &patternGain, 1, 1, 3 );
			if ( (cntSetup1 / 250) % 2 != 0 ) {
				lcdRowPrintf(LOWER, "%2d %2d %2d", yawRateCtrl.kp, yawRateCtrl.ki, yawRateCtrl.kd);
			}
			switch( patternGain ) {
				case 1:
					// kp
					dataTuningUD ( &yawRateCtrl.kp, 1, 0, 99 );
					//値を点滅
					if ( (cntSetup1 / 250) % 2 == 0 ) {
						lcdRowPrintf(LOWER, "   %2d %2d", yawRateCtrl.ki, yawRateCtrl.kd);
					}
					break;
				case 2:
					// ki
					dataTuningUD ( &yawRateCtrl.ki, 1, 0, 99 );
					//値を点滅
					if ( (cntSetup1 / 250) % 2 == 0 ) {
						lcdRowPrintf(LOWER, "%2d    %2d", yawRateCtrl.kp, yawRateCtrl.kd);
					}
					break;
				case 3:
					// kd
					dataTuningUD ( &yawRateCtrl.kd, 1, 0, 99 );
					//値を点滅
					if ( (cntSetup1 / 250) % 2 == 0 ) {
						lcdRowPrintf(LOWER, "%2d %2d   ", yawRateCtrl.kp, yawRateCtrl.ki);
					}
					break;
			}
			break;
		//------------------------------------------------------------------
		// ゲイン調整(角度)
		//------------------------------------------------------------------
		case HEX_PID_ANGLE:
			lcdRowPrintf(UPPER, "Angle   ");
			// lcdRowPrintf(UPPER, "   %3.2f",BNO055val.angle.z);
			
			// 目標角度を時間で切り替える
			if (cntSetup2 < 5000) {
				setTargetAngle(0.78);
			} else {
				setTargetAngle(-0.78);
			} 					
			if (cntSetup2 > 10000)	cntSetup2 = 0;
			setTargetSpeed(0);

			data_select( &trace_test, SW_PUSH );
			// PUSHでトレースON/OFF
			if ( trace_test == 1 ) {
				useIMU = true;
				motorPwmOutSynth( 0, veloCtrl.pwm, yawRateCtrl.pwm, yawCtrl.pwm );
			} else {
				BNO055val.angle.z = 0;
				useIMU = false;
				motorPwmOutSynth( 0, 0, 0, 0 );
			}
			
			dataTuningLR( &patternGain, 1, 1, 3 );
			if ( (cntSetup1 / 250) % 2 != 0 ) {
				lcdRowPrintf(LOWER, "%2d %2d %2d", yawCtrl.kp, yawCtrl.ki, yawCtrl.kd);
			}
			switch( patternGain ) {
				case 1:
					// kp
					dataTuningUD ( &yawCtrl.kp, 1, 0, 99 );
					//値を点滅
					if ( (cntSetup1 / 250) % 2 == 0 ) {
						lcdRowPrintf(LOWER, "   %2d %2d", yawCtrl.ki, yawCtrl.kd);
					}
					break;
				case 2:
					// ki
					dataTuningUD ( &yawCtrl.ki, 1, 0, 99 );
					//値を点滅
					if ( (cntSetup1 / 250) % 2 == 0 ) {
						lcdRowPrintf(LOWER, "%2d    %2d", yawCtrl.kp, yawCtrl.kd);
					}
					break;
				case 3:
					// kd
					dataTuningUD ( &yawCtrl.kd, 1, 0, 99 );
					//値を点滅
					if ( (cntSetup1 / 250) % 2 == 0 ) {
						lcdRowPrintf(LOWER, "%2d %2d   ", yawCtrl.kp, yawCtrl.ki);
					}
					break;
			}
			break;

	default:
		lcdRowPrintf(UPPER, "%#x     ", swValRotary);
		lcdRowPrintf(LOWER, "none    ");
		break;
	} // switch
	// } // cntSW
}
///////////////////////////////////////////////////////////////////////////////////////
// モジュール名 data_select
// 処理概要     タクトスイッチで0,1に変化させる
// 引数         data: 変化させる変数 button: どのスイッチで変化させるか
// 戻り値       なし
///////////////////////////////////////////////////////////////////////////////////////
void data_select ( uint8_t *data , uint8_t button ) {
	if ( swValTact == button ) {
		if ( *data == 1 && push == 0) {
			push = 1;
			*data = 0;
		} else if ( *data == 0 && push == 0) {
			push = 1;
			*data = 1;
		}
	} else {
		push = 0;
	}
}
///////////////////////////////////////////////////////////////////////////////////////
// モジュール名 dataTuningUD
// 処理概要     タクトスイッチでdataを加減する
// 引数         data: 加減させる変数 add: 0: 変化量 dir: 0:上下 1:左右
// 戻り値       なし
///////////////////////////////////////////////////////////////////////////////////////
void dataTuningUD ( int16_t *data, int16_t add, int16_t min, int16_t max) {
	if ( cntSwitchUD >= 50 ) {
		if ( swValTact == SW_UP || swValTact == SW_DOWN ) {
			cntSwitchUDLong++; // 長押し時間計測
			if ( swValTact == SW_UP  ) {
				// インクリメント
				if ( cntSwitchUDLong >= 20 ) {	// 長押し処理
					*data += add;
				} else if (pushUD == 0) {	// 1回押し処理
					pushUD = 1;
					*data += add;
				}
			} else if ( swValTact == SW_DOWN  ) {
				// デクリメント
				if ( cntSwitchUDLong >= 20 ) {	// 長押し処理
					*data -= add;
				} else if (pushUD == 0) {	// 1回押し処理
					pushUD = 1;
					*data -= add;
				}
			}
		} else {
			pushUD = 0;
			cntSwitchUDLong = 0;
		}
		cntSwitchUD = 0;

		if ( *data > max) {
			*data = min;
		} else if ( *data < min ) {
			*data = max;
		}
	}
}
///////////////////////////////////////////////////////////////////////////////////////
// モジュール名 dataTuningLR
// 処理概要     タクトスイッチでdataを加減する
// 引数         data: 加減させる変数 add: 0: 変化量 dir: 0:上下 1:左右
// 戻り値       なし
///////////////////////////////////////////////////////////////////////////////////////
void dataTuningLR ( int16_t *data, int16_t add, int16_t min, int16_t max) {
	if ( cntSwitchLR >= 50 ) {
		if ( swValTact == SW_LEFT || swValTact == SW_RIGHT ) {
			cntSwitchLRLong++; // 長押し時間計測
			if ( swValTact == SW_RIGHT  ) {
				// インクリメント
				if ( cntSwitchLRLong >= 20 ) {	// 長押し処理
					*data += add;
				} else if (pushLR == 0) {	// 1回押し処理
					pushLR = 1;
					*data += add;
				}
			} else if ( swValTact == SW_LEFT  ) {
				// デクリメント
				if ( cntSwitchLRLong >= 20 ) {	// 長押し処理
					*data -= add;
				} else if (pushLR == 0) {	// 1回押し処理
					pushLR = 1;
					*data -= add;
				}
			}
		} else {
			pushLR = 0;
			cntSwitchLRLong = 0;
		}
		cntSwitchLR = 0;

		if ( *data > max) {
			*data = min;
		} else if ( *data < min ) {
			*data = max;
		}
	}
}
///////////////////////////////////////////////////////////////////////////////////////
// モジュール名 dataTuningUDF
// 処理概要     タクトスイッチでdataを加減する
// 引数         data: 加減させる変数 add: 0: 変化量 dir: 0:上下 1:左右
// 戻り値       なし
///////////////////////////////////////////////////////////////////////////////////////
void dataTuningUDF ( float *data, float add, float min, float max) {
	if ( cntSwitchUD >= 50 ) {
		if ( swValTact == SW_UP || swValTact == SW_DOWN ) {
			cntSwitchUDLong++; // 長押し時間計測
			if ( swValTact == SW_UP  ) {
				// インクリメント
				if ( cntSwitchUDLong >= 20 ) {	// 長押し処理
					*data += add;
				} else if (pushUD == 0) {	// 1回押し処理
					pushUD = 1;
					*data += add;
				}
			} else if ( swValTact == SW_DOWN  ) {
				// デクリメント
				if ( cntSwitchUDLong >= 20 ) {	// 長押し処理
					*data -= add;
				} else if (pushUD == 0) {	// 1回押し処理
					pushUD = 1;
					*data -= add;
				}
			}
		} else {
			pushUD = 0;
			cntSwitchUDLong = 0;
		}
		cntSwitchUD = 0;

		if ( *data > max) {
			*data = min;
		} else if ( *data < min ) {
			*data = max;
		}
	}
}
