Kageyana/robotrace_v1/robotrace_v1/Core/Src/fatfs_sd.c

//====================================//
// インクルード
//====================================//
#include "fatfs_sd.h"
//====================================//
// グローバル変数の宣言
//====================================//
/* manage your SPI handler below */
extern volatile uint8_t Timer1, Timer2;                 /* 10ms Timer decreasing every time */

static volatile DSTATUS Stat = STA_NOINIT;              /* Disc Status Flag*/
static uint8_t CardType;                                /* SD type 0:MMC, 1:SDC, 2:Block addressing */
static uint8_t PowerFlag = 0;                           /* Power condition Flag */


/* SPI Chip Select */
static void SELECT(void)
{
  HAL_GPIO_WritePin(SD_CS_GPIO_Port, SD_CS_Pin, GPIO_PIN_RESET);
}

/* SPI Chip Deselect */
static void DESELECT(void)
{
  HAL_GPIO_WritePin(SD_CS_GPIO_Port, SD_CS_Pin, GPIO_PIN_SET);
}

/* SPI Transmit*/
static void SPI_TxByte(BYTE data)
{
  while (HAL_SPI_GetState(&hspi3) != HAL_SPI_STATE_READY);
  HAL_SPI_Transmit(&hspi3, &data, 1, SPI_TIMEOUT);
}

/* SPI Data send / receive return type function */
static uint8_t SPI_RxByte(void)
{
  uint8_t dummy, data;
  dummy = 0xFF;
  data = 0;
  
  while ((HAL_SPI_GetState(&hspi3) != HAL_SPI_STATE_READY));
  HAL_SPI_TransmitReceive(&hspi3, &dummy, &data, 1, SPI_TIMEOUT);
  
  return data;
}

/* SPI Data send / receive pointer type function*/
static void SPI_RxBytePtr(uint8_t *buff) 
{
  *buff = SPI_RxByte();
}

/* SD CARD Ready wait */
static uint8_t SD_ReadyWait(void) 
{
  uint8_t res;
  
  /* 500ms Counter preparation*/
  Timer2 = 50;

  SPI_RxByte();
  
  do
  {
    /* 0xFF SPI communication until a value is received */
    res = SPI_RxByte();
  } while ((res != 0xFF) && Timer2);
  
  return res;
}

/*Power on*/
static void SD_PowerOn(void) 
{
  uint8_t cmd_arg[6];
  uint32_t Count = 0x1FFF;
  

  DESELECT();
  
  for(int i = 0; i < 10; i++)
  {
    SPI_TxByte(0xFF);
  }
  
  /* SPI Chips Select */
  SELECT();
  
  /*  GO_IDLE_STATE State transitions*/
  cmd_arg[0] = (CMD0 | 0x40);
  cmd_arg[1] = 0;
  cmd_arg[2] = 0;
  cmd_arg[3] = 0;
  cmd_arg[4] = 0;
  cmd_arg[5] = 0x95;
  
  /* Command transmission*/
  for (int i = 0; i < 6; i++)
  {
    SPI_TxByte(cmd_arg[i]);
  }
  
  /* Answer waiting*/
  while ((SPI_RxByte() != 0x01) && Count)
  {
    Count--;
  }
  
  DESELECT();
  SPI_TxByte(0XFF);
  
  PowerFlag = 1;
}

/* 電源を切る */
static void SD_PowerOff(void) 
{
  PowerFlag = 0;
}

/* 電源状態の確認 */
static uint8_t SD_CheckPower(void) 
{
  /*  0=off, 1=on */
  return PowerFlag;
}

/* データパケットの受信 */
static bool SD_RxDataBlock(BYTE *buff, UINT btr) 
{
  uint8_t token;
  
  /* 100ms タイマー */
  Timer1 = 10;

  /* 応答待ち */		
  do 
  {    
    token = SPI_RxByte();
  } while((token == 0xFF) && Timer1);
  
  /* 0xFE 以外トークン受信時のエラー処理 */
  if(token != 0xFE)
    return FALSE;
  
  /* バッファへのデータの受信 */
  do 
  {     
    SPI_RxBytePtr(buff++);
    SPI_RxBytePtr(buff++);
  } while(btr -= 2);
  
  SPI_RxByte(); /* CRC 無視 */
  SPI_RxByte();
  
  return TRUE;
}

/* データ転送パケット */
#if _READONLY == 0
static bool SD_TxDataBlock(const BYTE *buff, BYTE token)
{
  uint8_t resp, wc;
  uint8_t i = 0;
    
  /* SDカード準備待ち */
  if (SD_ReadyWait() != 0xFF)
    return FALSE;
  
  /* トークン転送 */
  SPI_TxByte(token);      
  
  /* データトークンの場合 */
  if (token != 0xFD) 
  { 
    wc = 0;
    
    /* 512バイトのデータ転送 */
    do 
    { 
      SPI_TxByte(*buff++);
      SPI_TxByte(*buff++);
    } while (--wc);
    
    SPI_RxByte();       /* CRC 無視 */
    SPI_RxByte();
    
    /* デートレスポンスの受信 */        
    while (i <= 64) 
    {			
      resp = SPI_RxByte();
      
      /* エラー応答処理 */
      if ((resp & 0x1F) == 0x05) 
        break;
      
      i++;
    }
    
    /* SPI 受信バッファ Clear*/
    while (SPI_RxByte() == 0);
  }
  
  if ((resp & 0x1F) == 0x05)
    return TRUE;
  else
    return FALSE;
}
#endif /* _READONLY */

/* CMD パケット転送 */
static BYTE SD_SendCmd(BYTE cmd, DWORD arg) 
{
  uint8_t crc, res;
  
  /* SDカード待ち */
  if (SD_ReadyWait() != 0xFF)
    return 0xFF;
  
  /* コマンドパケット転送 */
  SPI_TxByte(cmd); 			/* Command */
  SPI_TxByte((BYTE) (arg >> 24)); 	/* Argument[31..24] */
  SPI_TxByte((BYTE) (arg >> 16)); 	/* Argument[23..16] */
  SPI_TxByte((BYTE) (arg >> 8)); 	/* Argument[15..8] */
  SPI_TxByte((BYTE) arg); 		/* Argument[7..0] */
  
  /* コマンドによるCRCの準備 */
  crc = 0;  
  if (cmd == CMD0)
    crc = 0x95; /* CRC for CMD0(0) */
  
  if (cmd == CMD8)
    crc = 0x87; /* CRC for CMD8(0x1AA) */
  
  /* CRC 転送 */
  SPI_TxByte(crc);
  
  /* CMD12 Stop Readingコマンドの場合は、応答バイトを1つ捨てる */
  if (cmd == CMD12)
    SPI_RxByte();
  
  /* 10回以内に正常データを受信する. */
  uint8_t n = 10; 
  do
  {
    res = SPI_RxByte();
  } while ((res & 0x80) && --n);

  return res;
}

/*-----------------------------------------------------------------------
  fatfsで使用されるグローバル関数
  user_diskio.cファイルで使用される.
-----------------------------------------------------------------------*/

/* SDカードの初期化 */
DSTATUS SD_disk_initialize(BYTE drv) 
{
  uint8_t n, type, ocr[4];
  
  /* 一種類のドライブのみサポート */
  if(drv)
    return STA_NOINIT;  
  
  /* SDカード未挿入 */
  if(Stat & STA_NODISK)
    return Stat;        
  
  /* SDカード Power On */
  SD_PowerOn();         
  
  /* SPI 通信のために Chip Select */
  SELECT();             
  
  /* SDカードタイプ変数の初期化 */
  type = 0;
  
  /* Idle ステータスエントリー */
  if (SD_SendCmd(CMD0, 0) == 1) 
  { 
    /* タイマー1秒設定 */
    Timer1 = 100;
    
    /* SD インタフェース動作条件の確認 */
    if (SD_SendCmd(CMD8, 0x1AA) == 1) 
    { 
      /* SDC Ver2+ */
      for (n = 0; n < 4; n++)
      {
        ocr[n] = SPI_RxByte();
      }
      
      if (ocr[2] == 0x01 && ocr[3] == 0xAA) 
      { 
        /* 2.7-3.6V 電圧範囲動作 */
        do {
          if (SD_SendCmd(CMD55, 0) <= 1 && SD_SendCmd(CMD41, 1UL << 30) == 0)
            break; /* ACMD41 with HCS bit */
        } while (Timer1);
        
        if (Timer1 && SD_SendCmd(CMD58, 0) == 0) 
        { 
          /* Check CCS bit */
          for (n = 0; n < 4; n++)
          {
            ocr[n] = SPI_RxByte();
          }
          
          type = (ocr[0] & 0x40) ? 6 : 2;
        }
      }
    } 
    else 
    { 
      /* SDC Ver1 or MMC */
      type = (SD_SendCmd(CMD55, 0) <= 1 && SD_SendCmd(CMD41, 0) <= 1) ? 2 : 1; /* SDC : MMC */
      
      do {
        if (type == 2) 
        {
          if (SD_SendCmd(CMD55, 0) <= 1 && SD_SendCmd(CMD41, 0) == 0)
            break; /* ACMD41 */
        } 
        else 
        {
          if (SD_SendCmd(CMD1, 0) == 0)
            break; /* CMD1 */
        }
      } while (Timer1);
      
      if (!Timer1 || SD_SendCmd(CMD16, 512) != 0) 
      {
        /* ブロック長の選択 */
        type = 0;
      }
    }
  }
  
  CardType = type;
  
  DESELECT();
  
  SPI_RxByte(); /* Idle 状態遷移 (Release DO) */
  
  if (type) 
  {
    /* Clear STA_NOINIT */
    Stat &= ~STA_NOINIT; 
  }
  else
  {
    /* Initialization failed */
    SD_PowerOff();
  }
  
  return Stat;
}

/* ディスクの状態の確認 */
DSTATUS SD_disk_status(BYTE drv) 
{
  if (drv)
    return STA_NOINIT; 
  
  return Stat;
}

/* セクターを読む */
DRESULT SD_disk_read(BYTE pdrv, BYTE* buff, DWORD sector, UINT count) 
{
  if (pdrv || !count)
    return RES_PARERR;
  
  if (Stat & STA_NOINIT)
    return RES_NOTRDY;
  
  if (!(CardType & 4))
    sector *= 512;      /* 指定 sector を Byte addressing 単位に変更 */
  
  SELECT();
  
  if (count == 1) 
  { 
    /* シングルブロックを読む */
    if ((SD_SendCmd(CMD17, sector) == 0) && SD_RxDataBlock(buff, 512))
      count = 0;
  } 
  else 
  { 
    /* マルチブロック読み取り */
    if (SD_SendCmd(CMD18, sector) == 0) 
    {       
      do {
        if (!SD_RxDataBlock(buff, 512))
          break;
        
        buff += 512;
      } while (--count);
      
      /* STOP_TRANSMISSION, すべてのブロックをすべて読んだ後、転送停止要求 */
      SD_SendCmd(CMD12, 0); 
    }
  }
  
  DESELECT();
  SPI_RxByte(); /* Idle 状態(Release DO) */
  
  return count ? RES_ERROR : RES_OK;
}

/* セクターを書く */
#if _READONLY == 0
DRESULT SD_disk_write(BYTE pdrv, const BYTE* buff, DWORD sector, UINT count) 
{
  if (pdrv || !count)
    return RES_PARERR;
  
  if (Stat & STA_NOINIT)
    return RES_NOTRDY;
  
  if (Stat & STA_PROTECT)
    return RES_WRPRT;
  
  if (!(CardType & 4))
    sector *= 512; /* 指定 sector を Byte addressing 単位に変更 */
  
  SELECT();
  
  if (count == 1) 
  { 
    /* シングルブロック書き込み */
    if ((SD_SendCmd(CMD24, sector) == 0) && SD_TxDataBlock(buff, 0xFE))
      count = 0;
  } 
  else 
  { 
    /* マルチブロック書き込み */
    if (CardType & 2) 
    {
      SD_SendCmd(CMD55, 0);
      SD_SendCmd(CMD23, count); /* ACMD23 */
    }
    
    if (SD_SendCmd(CMD25, sector) == 0) 
    {       
      do {
        if(!SD_TxDataBlock(buff, 0xFC))
          break;
        
        buff += 512;
      } while (--count);
      
      if(!SD_TxDataBlock(0, 0xFD))
      {        
        count = 1;
      }
    }
  }
  
  DESELECT();
  SPI_RxByte();
  
  return count ? RES_ERROR : RES_OK;
}
#endif /* _READONLY */

/* その他の機能 */
DRESULT SD_disk_ioctl(BYTE drv, BYTE ctrl, void *buff) 
{
  DRESULT res;
  BYTE n, csd[16], *ptr = buff;
  WORD csize;
  
  if (drv)
    return RES_PARERR;
  
  res = RES_ERROR;
  
  if (ctrl == CTRL_POWER) 
  {
    switch (*ptr) 
    {
    case 0:
      if (SD_CheckPower())
        SD_PowerOff();          /* Power Off */
      res = RES_OK;
      break;
    case 1:
      SD_PowerOn();             /* Power On */
      res = RES_OK;
      break;
    case 2:
      *(ptr + 1) = (BYTE) SD_CheckPower();
      res = RES_OK;             /* Power Check */
      break;
    default:
      res = RES_PARERR;
    }
  } 
  else 
  {
    if (Stat & STA_NOINIT)
      return RES_NOTRDY;
    
    SELECT();
    
    switch (ctrl) 
    {
    case GET_SECTOR_COUNT: 
      /* SDカード内のSectorの数 (DWORD) */
      if ((SD_SendCmd(CMD9, 0) == 0) && SD_RxDataBlock(csd, 16)) 
      {
        if ((csd[0] >> 6) == 1) 
        { 
          /* SDC ver 2.00 */
          csize = csd[9] + ((WORD) csd[8] << 8) + 1;
          *(DWORD*) buff = (DWORD) csize << 10;
        } 
        else 
        { 
          /* MMC or SDC ver 1.XX */
          n = (csd[5] & 15) + ((csd[10] & 128) >> 7) + ((csd[9] & 3) << 1) + 2;
          csize = (csd[8] >> 6) + ((WORD) csd[7] << 2) + ((WORD) (csd[6] & 3) << 10) + 1;
          *(DWORD*) buff = (DWORD) csize << (n - 9);
        }
        
        res = RES_OK;
      }
      break;
      
    case GET_SECTOR_SIZE: 
      /* セクタの単位サイズ (WORD) */
      *(WORD*) buff = 512;
      res = RES_OK;
      break;
      
    case CTRL_SYNC: 
      /* 書き込み同期 */
      if (SD_ReadyWait() == 0xFF)
        res = RES_OK;
      break;
      
    case MMC_GET_CSD: 
      /* CSD情報の受信 (16 bytes) */
      if (SD_SendCmd(CMD9, 0) == 0 && SD_RxDataBlock(ptr, 16))
        res = RES_OK;
      break;
      
    case MMC_GET_CID: 
      /* CID情報の受信 (16 bytes) */
      if (SD_SendCmd(CMD10, 0) == 0 && SD_RxDataBlock(ptr, 16))
        res = RES_OK;
      break;
      
    case MMC_GET_OCR: 
      /* OCR情報の受信 (4 bytes) */
      if (SD_SendCmd(CMD58, 0) == 0) 
      {         
        for (n = 0; n < 4; n++)
        {
          *ptr++ = SPI_RxByte();
        }
        
        res = RES_OK;
      }     
      
    default:
      res = RES_PARERR;
    }
    
    DESELECT();
    SPI_RxByte();
  }
  
  return res;
}
