Kageyana/robotrace_v1/robotrace_v1/Core/Src/AQM0802A.c

//======================================//
// インクルード
//======================================//
#include "AQM0802A.h"
//====================================//
// グローバル変数の宣言
//====================================//
// LCD関連
static volatile uint8_t	        buffLcdData[ LCD_MAX_X / LCD_MAX_Y ];		// 表示バッファ
static uint8_t				    buffLcdData2[ LCD_MAX_X / LCD_MAX_Y + 10 ]; // 表示バッファ一時作業エリア
static volatile uint16_t		lcdBuffPosition;				// バッファに書き込む位置
static volatile uint16_t		lcdMode2 = 1;					// 表示処理No管理
static volatile uint16_t		lcdNowLocate;					// 現在の表示している位置
static volatile uint16_t		lcdRefreshFlag;					// リフレッシュフラグ

//////////////////////////////////////////////////////////////////////////
// モジュール名 writeLCDData
// 処理概要     データ送信
// 引数         data
// 戻り値       なし
//////////////////////////////////////////////////////////////////////////
void writeLCDData( uint8_t data ) {
	uint8_t tx_buf[2] = { RSBIT1, data };
	I2C_LCD_SEND
}
//////////////////////////////////////////////////////////////////////////
// モジュール名 writeLCDCMD
// 処理概要     コマンド送信
// 引数         cmd
// 戻り値       なし
//////////////////////////////////////////////////////////////////////////
void writeLCDCMD( uint8_t cmd ) {
	uint8_t tx_buf[2] = { RSBIT0, cmd };
 	I2C_LCD_SEND
}
//////////////////////////////////////////////////////////////////////////
// モジュール名 intiLcd
// 処理概要     LCDの初期化
// 引数         なし
// 戻り値       なし
//////////////////////////////////////////////////////////////////////////
 bool intiLcd(void) {
    uint8_t tx_buf[2] = { RSBIT0, 0x38 };

    if (HAL_I2C_Master_Transmit(&hi2c1,LCD_SLAVEADDRESS,tx_buf,2,1) == HAL_OK) {
        // HAL_Delay(4);
        // writeLCDCMD(0x38);	// function set			: データ線は8本・表示は２行・フォントは5x8ドット
        HAL_Delay(1);
        writeLCDCMD(0x39);	// function set           	: 拡張コマンドの設定を有効にする
        HAL_Delay(1);
        writeLCDCMD(0x14);	// Internal OSC frequency 	: バイアスの選択と内部OSC周波数の調整
        HAL_Delay(1);
        writeLCDCMD(0x70);	// Contrast set          	: コントラスト調整データ(下位4ビット)
        HAL_Delay(1);
        writeLCDCMD(0x56);	// Power/ICON/Contrast control	: 昇圧回路有効、コントラスト調整データ(上位2ビット)
        HAL_Delay(1);
        writeLCDCMD(0x6c);	// Follower control     	: フォロア回路をON、増幅率の調整を行う
        HAL_Delay(200);
        writeLCDCMD(0x38);	// function set         	: 拡張コマンドを設定を無効にする
        HAL_Delay(1);
        writeLCDCMD(0x0c);	// display ON/OFF control      	: 画面表示はON・カーソル表示はOFF・カーソル点滅はOFF
        HAL_Delay(1);
        writeLCDCMD(0x01);	// Clear Display 		: 画面全体に20Hのｽﾍﾟｰｽで表示、ｶｰｿﾙはcol=0,row=0に移動
        HAL_Delay(2);

        return true;
    } else {
        return false;
    }
}
//////////////////////////////////////////////////////////////////////////
// モジュール名 lcdLocate
// 処理概要     液晶カーソル移動
// 引数         x , y
// 戻り値       なし
//////////////////////////////////////////////////////////////////////////
void lcdClear(void) {
    lcdRowPrintf(UPPER, "        ");
	lcdRowPrintf(LOWER, "        ");
    // writeLCDCMD(0x01);
}
//////////////////////////////////////////////////////////////////////////
// モジュール名 lcdLocate
// 処理概要     液晶カーソル移動
// 引数         x , y
// 戻り値       なし
//////////////////////////////////////////////////////////////////////////
static void lcdLocate( uint16_t x, uint16_t y ) {
    volatile uint8_t work = 0x80;

    // xの計算
    work += x;

    // yの計算
    if( y == 1 ) {
        work += 0x40;
    } else if( y == 2 ) {
        work += 0x14;
    } else if( y == 3 ) {
        work += 0x54;
    }

    // カーソル移動
    writeLCDCMD(work);
}
//////////////////////////////////////////////////////////////////////////
// モジュール名 lcdShowProcess
// 処理概要     液晶表示処理
// 引数         なし
// 戻り値       なし
// メモ         この関数は割り込みで1msごとに実行してください
//////////////////////////////////////////////////////////////////////////
void lcdShowProcess( void ) {
    switch( lcdMode2 ) {
    case 1: // データ更新されたかチェック
    	if( lcdRefreshFlag ) {
    		lcdRefreshFlag = 0;
    		lcdMode2 = 2;
	    }
        break;

    case 2: // 位置初期化
	    lcdNowLocate = 0;
    	lcdLocate( 0, 0 );
	    lcdMode2 = 3;
        break;

    case 3: // 改行位置の確認
        if( lcdNowLocate % LCD_MAX_X == 0 ) {
            lcdLocate( 0, lcdNowLocate / LCD_MAX_X );
        }
        lcdMode2 = 4;
        break;

    case 4: // データ表示処理
        writeLCDData(buffLcdData[ lcdNowLocate++ ]);
        if( lcdNowLocate >= LCD_MAX_X * LCD_MAX_Y ) {
            lcdMode2 = 1;
        } else {
            lcdMode2 = 3;
        }
        break;

    default:
	    lcdMode2 = 1;
   	    break;
    }
}
//////////////////////////////////////////////////////////////////////////
// モジュール名 lcdPrintf
// 処理概要     液晶へ表示 表示位置は過去に表示した位置の次から
// 引数         printfと同じ
// 戻り値       正常時：出力した文字列 異常時：負の数
//////////////////////////////////////////////////////////////////////////
int lcdPrintf(uint8_t *format, ...) {
    va_list argptr;
    volatile uint8_t    *p;
    volatile uint16_t     ret = 0;

    va_start(argptr, format);
    ret = vsprintf( buffLcdData2, format, argptr );
    va_end(argptr);

    if( ret > 0 ) {
        // vsprintfが正常なら液晶バッファへ転送
        p = buffLcdData2;
        while( *p ) {
            buffLcdData[lcdBuffPosition++] = *p++;
            if( lcdBuffPosition >= LCD_MAX_X * LCD_MAX_Y ) {
                lcdBuffPosition = 0;
            }
        }
        lcdRefreshFlag = 1;
    }
    return ret;
}
//////////////////////////////////////////////////////////////////////////
// モジュール名 lcdPosition
// 処理概要     液晶の表示位置指定
// 引数         横位置 , 縦位置
// 戻り値       なし
//////////////////////////////////////////////////////////////////////////
void lcdPosition(uint8_t x ,uint8_t y) {
    if( x >= LCD_MAX_X ) return;
    if( y >= LCD_MAX_Y ) return;

    lcdBuffPosition = x + y * LCD_MAX_X;
}
//////////////////////////////////////////////////////////////////////////
// モジュール名 lcdPrintf
// 処理概要     液晶へ表示 表示位置は過去に表示した位置の次から
// 引数         printfと同じ
// 戻り値       正常時：出力した文字列 異常時：負の数
//////////////////////////////////////////////////////////////////////////
int lcdRowPrintf(uint8_t step, char *format, ...) {
    va_list argptr;
    volatile uint8_t    *p;
    volatile uint16_t     ret = 0;

	if(step == UPPER){
		lcdPosition( 0, 0 );
	} else if (step == LOWER){
		lcdPosition( 0, 1 );
	}

    va_start(argptr, format);
    ret = vsprintf( buffLcdData2, format, argptr );
    va_end(argptr);

    if( ret > 0 ) {
        // vsprintfが正常なら液晶バッファへ転送
        p = buffLcdData2;
        while( *p ) {
            buffLcdData[lcdBuffPosition++] = *p++;
            if( lcdBuffPosition >= LCD_MAX_X * LCD_MAX_Y ) {
                lcdBuffPosition = 0;
            }
        }
        lcdRefreshFlag = 1;
    }
    return ret;
}
