Kageyana/robotrace_v1/robotrace_v1/Core/Inc/setup.h

#ifndef SETUP_H_
#define SETUP_H_
//======================================//
// インクルード
//======================================//
#include "main.h"
#include <stdio.h>
//======================================//
// グローバル変数の宣言
//======================================//
#define UD	0       // 5方向タクトスイッチの上下方向
#define LR	1       // 5方向タクトスイッチの左右方向

#define CALIBRATIONSPEED 1.8F   // ラインセンサのキャリブレーション時の角速度[rad/s]

#define HEX_START       0x0
#define HEX_SPEED_PARAM 0x1
#define HEX_LOG         0x2
#define HEX_CALIBRATION 0x3
#define HEX_SENSORS     0x4
#define HEX_PID_TRACE   0x5
#define HEX_PID_SPEED   0x6
#define HEX_PID_ANGULAR 0x7
#define HEX_PID_ANGLE   0x8

//======================================//
// グローバル変数の宣言
//======================================//
// パターン関連
extern uint8_t		start;

// タイマ関連
extern uint16_t 	cntSetup1;
extern uint16_t 	cntSetup2;
extern uint16_t 	cntSwitchUD;		// スイッチ判定用右
extern uint16_t 	cntSwitchLR;		// スイッチ判定用左
extern uint16_t		cntSwitchUDLong;	// スイッチ長押し判定用右
extern uint16_t		cntSwitchLRLong;	// スイッチ長押し判定用左

// パラメータ関連
extern uint8_t      fixSpeed;

// フラグ関連
extern uint8_t      trace_test;

//======================================//
// プロトタイプ宣言
//======================================//
void setup(void);
void data_select ( uint8_t *data , uint8_t button );
void dataTuningUD ( int16_t *data, int16_t add, int16_t min, int16_t max);
void dataTuningLR ( int16_t *data, int16_t add, int16_t min, int16_t max);
void dataTuningUDF ( float *data, float add, float min, float max);

#endif /* SETUP_H_ */
