Kageyana/robotrace_v1/robotrace_v1/Core/Inc/timer.h

#ifndef TIMER_H_
#define TIMER_H_

//====================================//
// インクルード
//====================================//
#include "main.h"
//====================================//
// シンボル定義
//====================================//

//====================================//
// グローバル変数の宣言
//====================================//
extern uint32_t     cntRun;
extern uint32_t     cntLog;
//====================================//
// プロトタイプ宣言
//====================================//
void Interrupt1ms(void);
void Interrupt100us(void);

#endif // TIMER_H_
