Kageyana/robotrace_v1/robotrace_v1/Core/Inc/led.h

#ifndef LED_H_
#define LED_H_

//====================================//
// インクルード
//====================================//
#include "main.h"
//====================================//
// シンボル定義
//====================================//

//====================================//
// グローバル変数の宣言
//====================================//

//====================================//
// プロトタイプ宣言
//====================================//
void ledOut( uint8_t rgb );

#endif // LED_H_
