Kageyana/robotrace_v1/robotrace_v1/Core/Inc/io.h

#ifndef IO_H_
#define IO_H_

//====================================//
// インクルード
//====================================//
#include "main.h"
//====================================//
// シンボル定義
//====================================//

//====================================//
// グローバル変数の宣言
//====================================//

//====================================//
// プロトタイプ宣言
//====================================//
void ledOut( uint8_t rgb );
uint8_t getMarksensor ( void );

#endif // IO_H_
