Kageyana/robotrace_v1/(commit log)

2022-09-07 LCDが動いた
2022-09-17 ラインセンサの動作を確認した
2022-09-23 0.4m/sでトレースできた
2022-09-25 ゴールマーカーを検出して1周で止まった
2022-09-30 0.8m/sで走った
2022-10-02 0.6m/sでベンチマークコースを完走した
2022-10-03 クロスラインの読み飛ばし処理が動いた
2022-10-30 電流センサ(INA260)が動いた
2022-11-21 MicroSDカードにFAT32形式で書き込めた
2022-11-23 ログが取れるようになった
2022-11-23 gitignoreを追加
2022-11-26 走行ログを取れた
2022-11-27 緊急停止処理を追加
2022-11-27 マーカー検知できた？
2022-12-03 マーカー検出アルゴリズムの改良
2022-12-03 コメントを翻訳した
2022-12-04 ログの保存を小分けにするようにした
2022-12-06 角度制御を追加
2022-12-06 FPUを有効化した
2022-12-10 マーカー検知改善
2022-12-10 microSDの挿入状況をフラグで管理するようにした
2022-12-18 コードを整理した
2023-01-01 起動時にMSDの挿入状況によってLEDの発光パターンを変えるようにした
2023-01-20 ライントレースの制御量を優先するようにした
2023-01-21 コード短縮
2023-02-05 角速度の単位をrad/sに変更した
2023-02-11 しきい値を[rad/s]に変更した
2023-02-11 SDカード関係の関数を外部ファイル化した
2023-02-11 コメントを追加
2023-02-16 マーカー区間ごとに曲率半径を算出できるようにした
2023-02-17 変数名変更
2023-02-17 2次走行用の機能を実装した
2023-02-18 全日本マイクロマウス大会2022試走日に走った
2023-02-20 2次走行用パラメータを調整できるようにした
2023-02-23 通信デバイスの初期化状況をフラグで管理するようにした
2023-02-24 マーカー誤検出処理を追加
2023-02-24 緊急停止処理を外部ファイル化した
2023-02-24 セットアップ画面、走行終了画面を変更した
2023-02-25 リセット時にSDAがlowに固定される問題を修正した
2023-02-25 パラメータ変数を構造体に変更した
2023-02-25 コードの可読性向上
2023-02-25 ジャイロ関係の変数を構造体に変更した
2023-02-25 インクルードパスを追加してエラー表示をなくした
2023-03-03 不要な処理を削除
2023-03-03 定義を変更
2023-03-12 コース記憶関数製作中
2023-03-18 PWMのDuty比指定をCounter Periodが最大値になるように変更した
2023-03-23 PWMのDuty比を0～counterperiodまで調整するようにした
2023-04-08 距離基準の記録走行ができた
2023-04-08 キャリブレーションをしないとスタートできないようにした
2023-04-09 クロスラインの通過時のブレを軽減した
2023-04-11 変数名を変更
2023-08-02 PIDパラメータを調整
2023-08-02 電気回路図を追加
    [BOM.csv, Markersensor.dxf, frontsensor.dxf, frontsensor2.dxf, plate.dxf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]
